Rmazze/LaserGame/README.md

# Lasertag with Arduino

This is an old project where I developed a lasertag kit with Arduino.

- In Arduino folder you can find the code for Arduino
- In pcb folder you can find the pcb board design
- In structure folder you can find the file for 3D printing the case
