Rmazze/LaserGame/lasertag_tesina.pdf

# ITT G. CHILESOTTI

# LASERTAG

# Anno scolastico 2017-2018

# Mazzaro Roberto 5^B

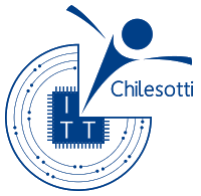
[picture p1: figure]

## Indice:

1. Introduzione
2. Fasi del progetto
3. Schema a blocchi

3.1 Schema blocchi kit

3.2 Schema a blocchi comunicazione tra due kit

4. Schema elettrico
5. PCB
6. Hardware per ricezione e trasmissione

6.1 Sensore IR

6.2 Circuito astabile con 555 per generare la frequenza di

38kHz

6.3 Dimensionamento circuito astabile

6.4 Schema elettrico circuito astabile con 555

7. Software

7.1 Acquisizione codice kit

7.2 Funzione di sparo

7.3 Funzione di ricezione

7.4 Funzione aggiornamento vita

7.5 Funzione ricarica

8. Misure con oscilloscopio
9. Struttura esterna
10. Approfondimento timer in ATMega 328
11. Listato programma

## 1. Introduzione

Cerchiamo innanzitutto di capire cos’è il lasertag.

Il lasertag è un gioco di squadra basato sulla simulazione militare.
L’attività simula, tramite apposite apparecchiature, combattimenti tra squadre avversarie. Gli obbiettivi sono vari, ma fondamentalmente lo scopo del gioco è colpire l’avversario fino alla sua eliminazione.
Ogni giocatore è munito di un kit a raggi infrarossi, totalmente innocui, collegato a dei sensori, posti generalmente sul capo o sul corpo, che devono essere colpiti.
È una tecnologia di derivazione militare, infatti è nata per l’addestramento delle forze militari.

## 2. Fasi del progetto

Il principale problema da risolvere per far funzionare questo progetto è capire come far comunicare due Arduino, ovvero il controllore utilizzato per sviluppare questo progetto, tramite un fascio infrarosso.
Risolto questo problema si può pensare al resto
Le fasi del progetto sono le seguenti
- Capire come far comunicare due Arduino tramite la funzione PulseIn()
- Capire come inserire la comunicazione con l’infrarosso
- Montare un prototipo su breadboard
- Scrivere le singole funzioni utilizzate dal software in linguaggio C
- Disegnare, sviluppare e montare il PCB
- Mettere a punto il programma generale
- Disegnare e realizzare la struttura con la stampante 3D

## 3. Schema a blocchi

### 3.1 Schema a blocchi di un kit

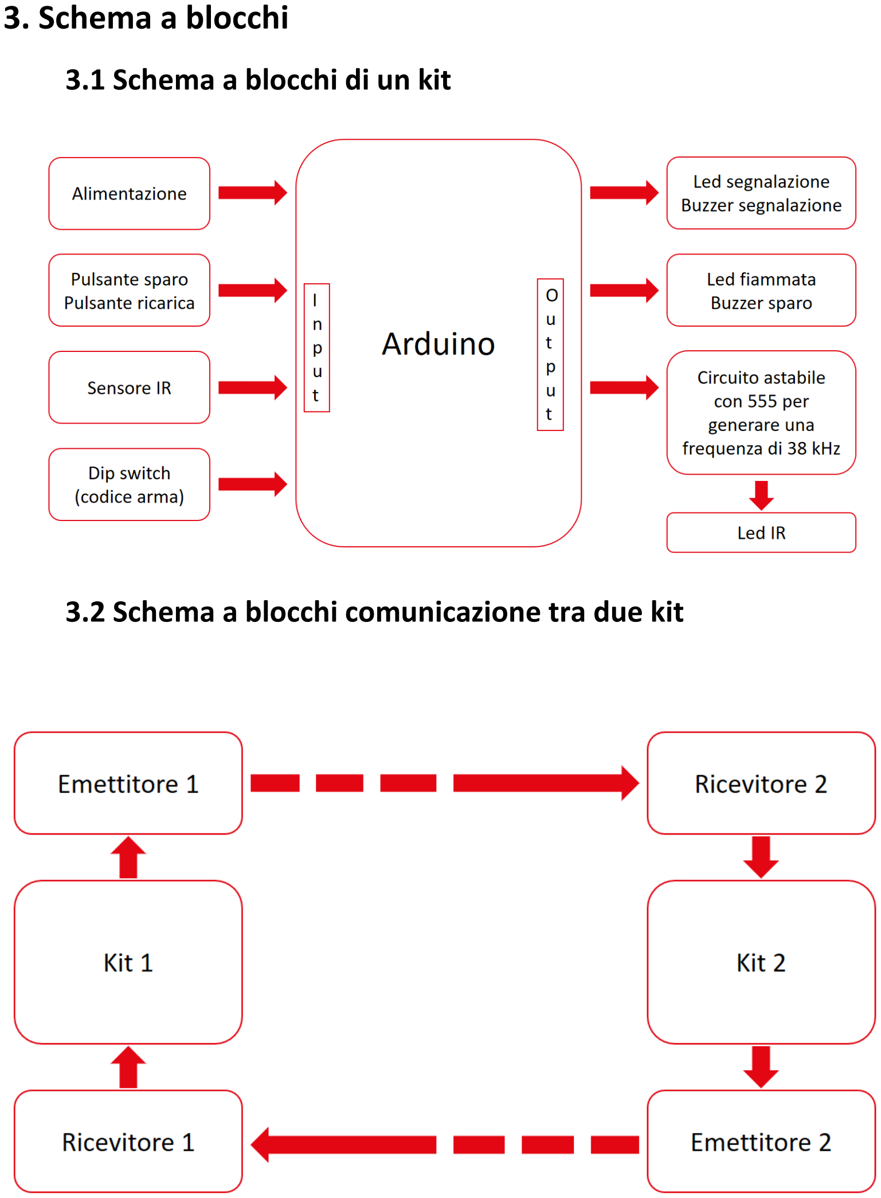
[picture p2: page 4]

### 3.2 Schema a blocchi comunicazione tra due kit

## 4. Schema elettrico

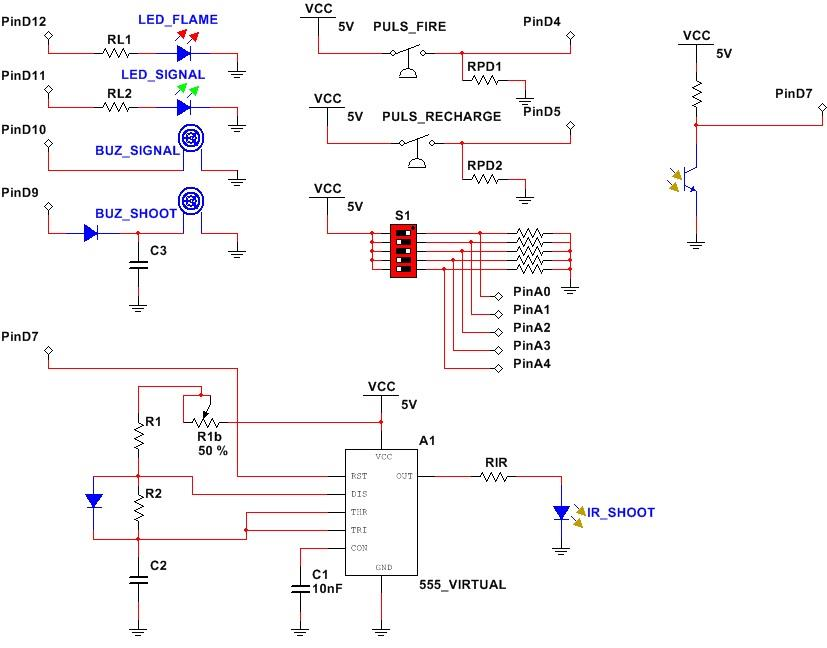
[picture p3: figure]

## 5.PCB

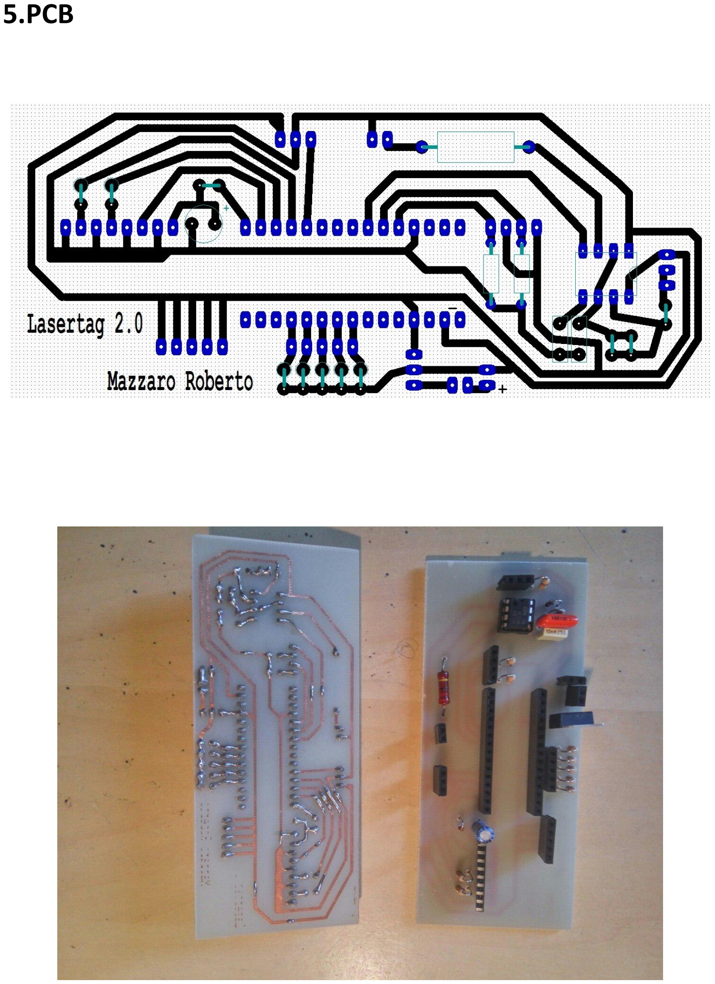
[picture p4: page 6]

## 6. Hardware

Di seguito vengono analizzate le parti principali dell’hardware.

### 6.1 Sensore IR

Il sensore infrarosso impiegato in ricezione è il TL1838.
È stato scelto perché è quello che si trova più facilmente in commercio.
Le caratteristiche peculiari di questo sensore sono:
- Frequenza di lavoro di 38kHz
- La durata minima di un impulso affinchè possa essere letto è di 600µS
- Quando riceve segnale in uscita fornisce 0V
- Quando non riceve il segnale adeguato in uscita fornisce 5V

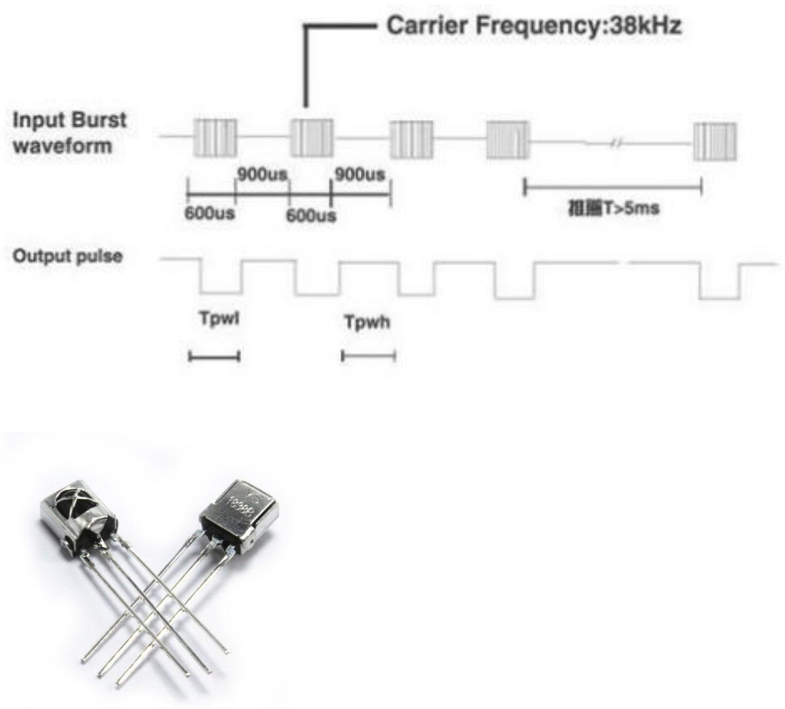
[picture p5: figure]

### 6.2 Hardware trasmissione

Dato che il sensore per funzionare correttamente necessita che gli venga fornito un segnale con una portante a 38kHz e dato che tutti i timer che mette a disposizione Arduino erano già impiegati per svolgere altre funzioni la frequenza di 38kHz viene generata tramite un 555 in configurazione astabile. Andando a pilotare il piedino di reset del 555 tramite Arduino si decide quando generare la frequenza di 38kHz che verrà spedita al kit avversario tramite un led IR collegato con un’opportuna resistenza al piedino d’uscita del 555.

### 6.3 Dimensionamento circuito astabile

f= 38kHz
T =

1
f

= 26.3µS
T = 0.7 ∗ [(R1 + R2

) ∗ C]
Scelgo C= 10nF
R1 + R2 =

T
0.7∗C

= 37571Ω
Scelgo R2= 15kΩ
R1= 12kΩ
R1B= trimmer da 10kΩ (per la regolazione dei 38kHz)

### 6.4 Schema elettrico circuito astabile con 555

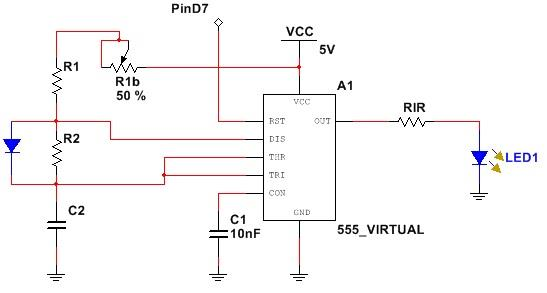
[picture p6: figure]

## 7. Software

Di seguito viene analizzato il software nelle sue componenti principali cercando di spiegare l’idea su cui esso si basa.

### 7.1: Acquisizione codice kit

Questa parte del programma viene eseguita una volta sola all’accensione perché si trova nel ´void setup()´.
Si va a fare la lettura analogica di 5 piedini che vanno da A0 ad A4,
questi piedini sono collegati ad un dip switch tramite il quale si può scegliere il codice del kit.
Vengono utilizzati dei piedini analogici per fare una lettura digitale perché erano inutilizzati e in Arduino ci sono a disposizione pochi piedini digitali. Dato che al momento sono stati acquisiti dei valori analogici questi devono essere convertiti in digitale, fatto ciò si ricava il codice della squadra e il codice dell’arma del kit, i primi due bit indicano il valore della squadra, mentre i restanti tre indicano il valore dell’arma.
In base al codice dell’arma si impostano le sue caratteristiche quali la vita, il rateo di fuoco, il numero di caricatori, i colpi per caricatore.

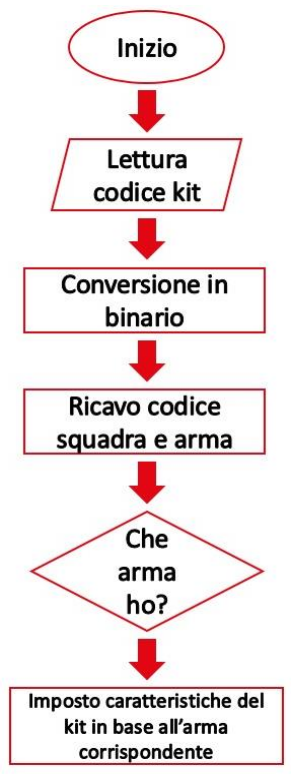
[picture p7: figure]

### 7.2 Funzione di sparo

La funzione di sparo è la funzione che si occupa di spedire il codice del kit al kit avversario.
È gestita con il timer1 che genera una frequenza che dipende dal tipo di arma selezionata, ogni volta che c’è il fronte di salita si spedisce il codice.
Per spedire il codice si agisce sul piedino di reset del 555, quando lo poniamo allo stato alto il 555 genera la frequenza di 38kHz.
Ad inizio trasmissione viene spedito il bit di start e per far ciò il reset del 555 viene abilitato per 1000µS.
Successivamente si spediscono il codice della squadra e quello dell’arma; per spedire un bit a 1 si abilita il reset del 555 per 800µS, mentre per spedire un bit a 0 lo si abilita per 600µS.
Dato che sia che si stia spedendo il bit di start uno 0 o un 1 si sta sempre spedendo un segnale infrarosso a 38kHz, solo che con diversa durata, per separare un bit dall’altro non si spedisce niente per 600µS.
Ogni volta che si spara, oltre a spedire il codice con il metodo precedentemente spiegato, si attivano anche il buzzer di sparo ed il led di fiammata e si scala un colpo dai colpi nel caricatore.
Gestire questa funzione con un interrupt è importante perché il programma deve essere sempre pronto a riceve un colpo avversario e per far ciò il programma non deve ‘bloccarsi’, quindi non ci possono essere delay inutili o eccessivamente lunghi.

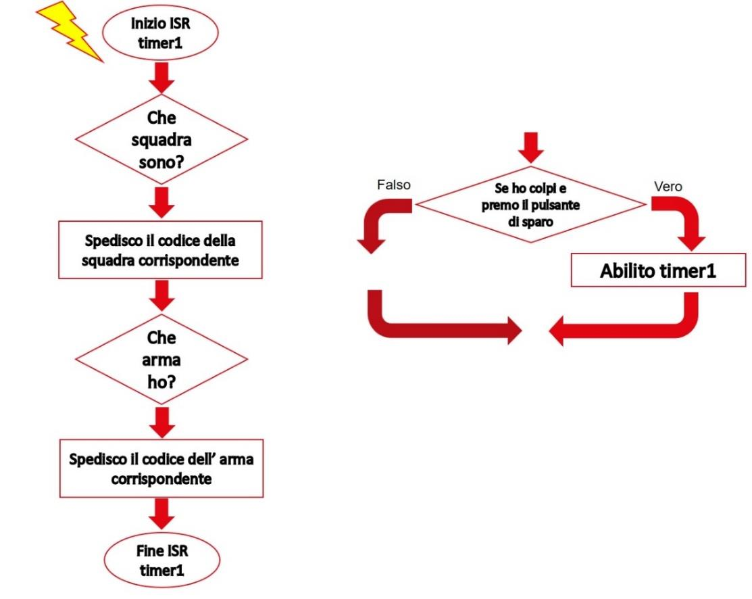
[picture p8: figure]

### 7.3 Funzione di ricezione

La funzione di ricezione si basa sulla funzione pulseIn(), che è una funzione già esistente nelle librerie di Arduino.
PulseIn() è una funzione che si occupa di restituire il valore in µS della durata dello stato alto o di quello basso in base al fatto che si decida di prendere come riferimento il fronte di salita o quello di discesa.
Viene utilizzata la funzione pulseIn() con l´opzione, già presente in essa, di inserire un timeout ovvero un tempo massimo entro il quale se non arriva il fronte desiderato la funzione pulseIn() procede oltre e ci restituisce come risultato 0µS.
I timeout sono necessari perché il programma non può restare ad aspettare un colpo che non si sa quando arriva e dobbiamo poter svolgere anche le altre azioni.
I timeout, se non vengono impostati, di base sono ad 1S.

Per ricevere il codice bisogna innanzitutto individuare il bit di start, per far ciò c’è un ciclo while che lavora fino a quando pulseIn() non rileva uno stato basso della durata di almeno 950µS, questo perché il bit di start dura 1000µS e ci vuole un po’ di margine;
all’interno del ciclo while si trova il resto del programma.
Rilevato il bit di start si esce dal ciclo while e tramite altri 5 pulseIn() si vanno ad acquisire le durate degli altri impulsi che successivamente vengono convertiti in 0 e 1, fatto ciò si ricavano il codice della squadra e dell’arma di chi ci ha colpito e si richiama la funzione di aggiornamento vita.

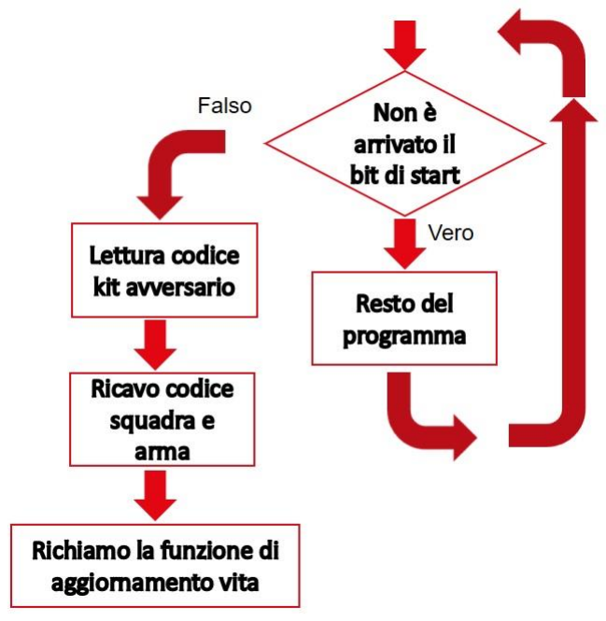
[picture p9: figure]

### 7.4 Funzione aggiornamento vita

Questa funzione viene eseguita dopo che si è stati colpiti e che i codici della squadra e dell’arma di colui che ci ha colpito sono stati ricavati.
Innanzitutto si fa un controllo per verificare che la squadra del kit che ha ricevuto il colpo sia diversa da quella del kit che l’ha spedito, se sono diverse allora, in base al codice dell’arma che ci ha colpito, si decrementa la variabile vita in base al danno che fa quell’arma, inoltre si accende il led ed il buzzer di segnalazione per segnalare che siamo stati colpiti.
Nel caso in cui le due squadre siano uguali il colpo non viene registrato e non si perde vita; è stato deciso di disabilitare il fuoco amico perché dato che il colpo è spedito tramite un fascio infrarosso che può essere riflesso c’era il rischio di colpirsi da soli.

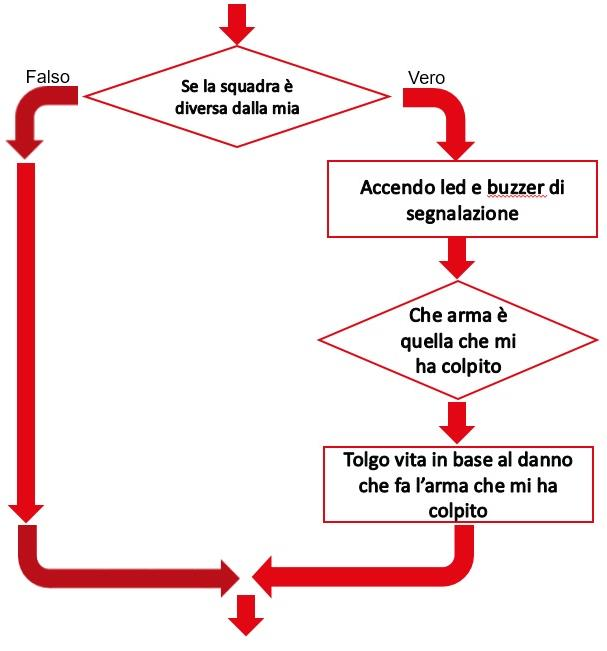
[picture p10: figure]

### 7.5 Funzione di ricarica

La funzione di ricarica viene eseguita quando si preme il pulsante di ricarica se si hanno ancora caricatori a disposizione.
Appena premuto il pulsante di ricarica si azzera la variabile colpi, così non è possibile sparare, inoltre si accendono e si spengono il led ed il buzzer di segnalazione.
Questa funzione è gestita con il timer2 impostato ad una frequenza fissa di 2kHz, per ottenere i vari tempi di ricarica richiesti dalle varie armi si aspetta che vengano eseguiti un certo numero di cicli dal timer, quindi c’è una variabile che tiene conto di quanti giri fa il timer e raggiunto il numero di cicli necessari si rispristinano i colpi nel caricatore e si decrementa la variabile caricatori.
È stato necessario adottare questa soluzione per il conteggio del tempo di ricarica perché il timer2 è un timer a soli 8 bit e con esso non è possibile ottenere i periodi lunghi necessari in questa funzione.

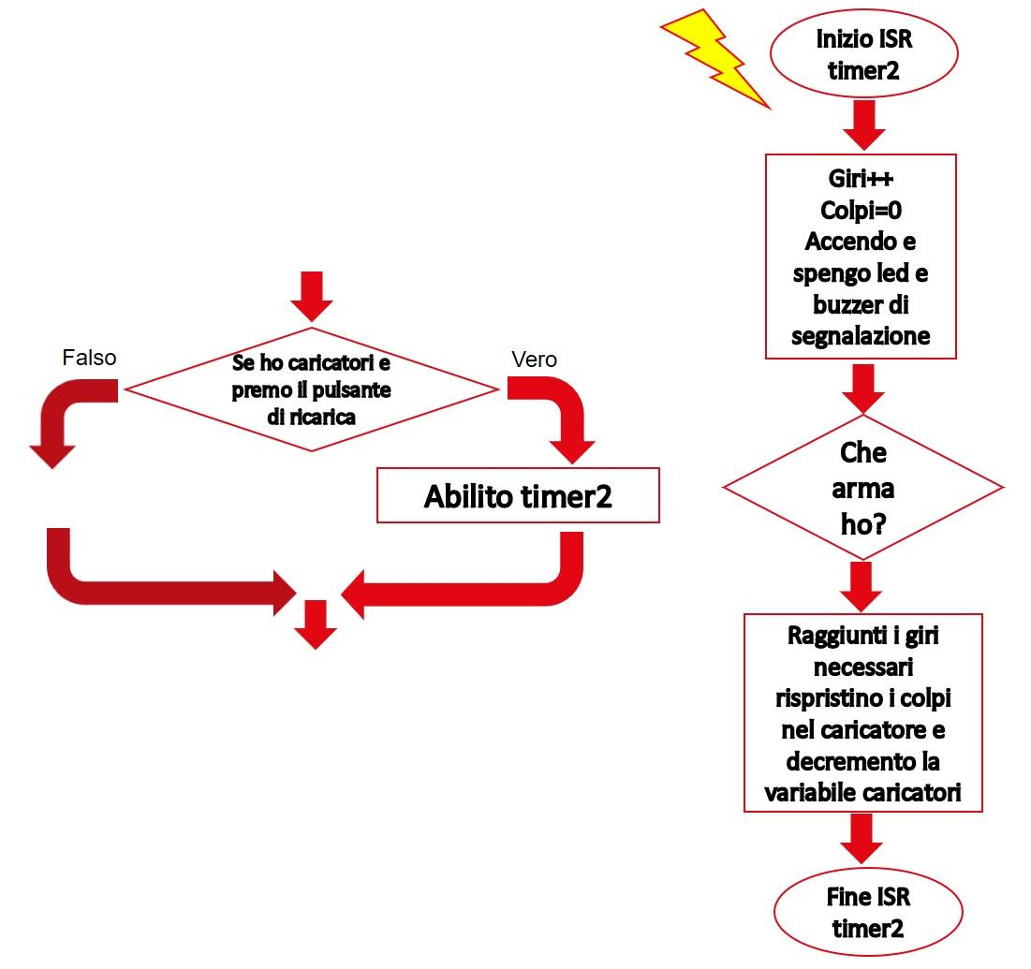
[picture p11: figure]

## 8. Misure con oscilloscopio

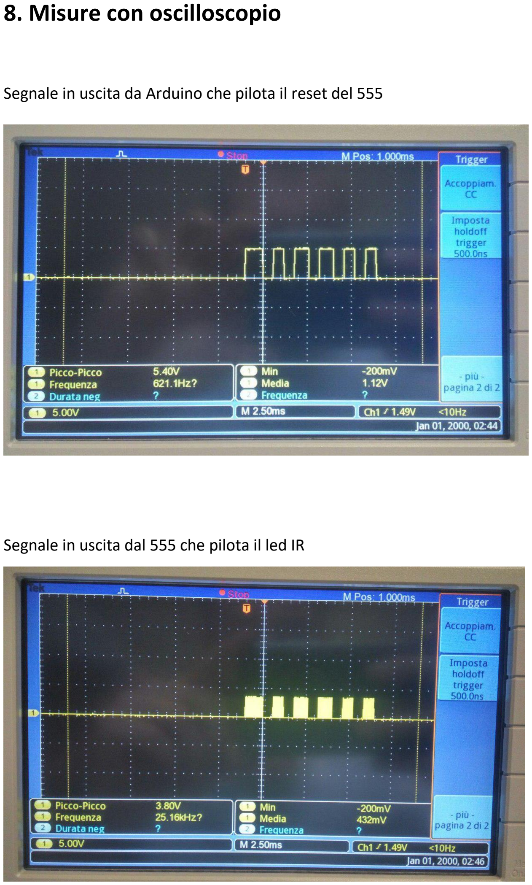
[picture p12: page 14]

Segnale in uscita da Arduino che pilota il reset del 555

Segnale in uscita dal 555 che pilota il led IR

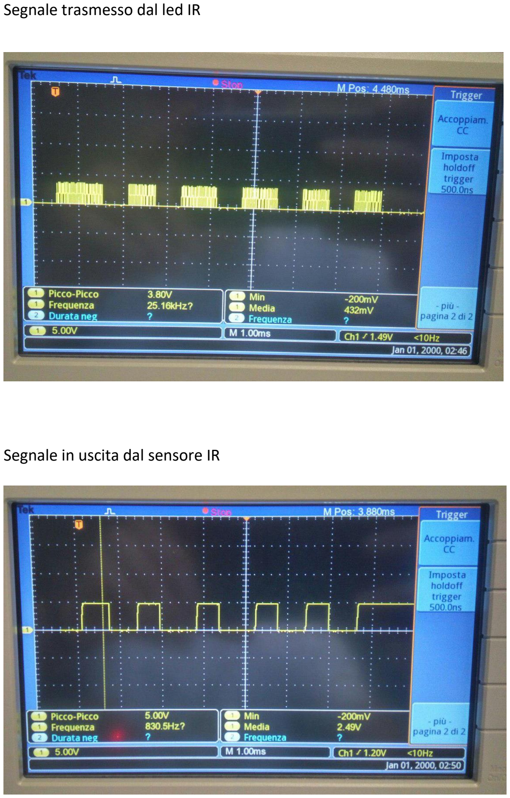
[picture p13: page 15]

Segnale trasmesso dal led IR

Segnale in uscita dal sensore IR

## 9. Struttura esterna

Il progetto della struttura esterna è stato realizzato con un programma di disegno 3D adatto alla creazione di file STL, ovvero il formato richiesto per la stampa in 3D, infatti la struttura esterna è stata successivamente realizzata con la stampante 3D.

Progetto in cad dell’ottica

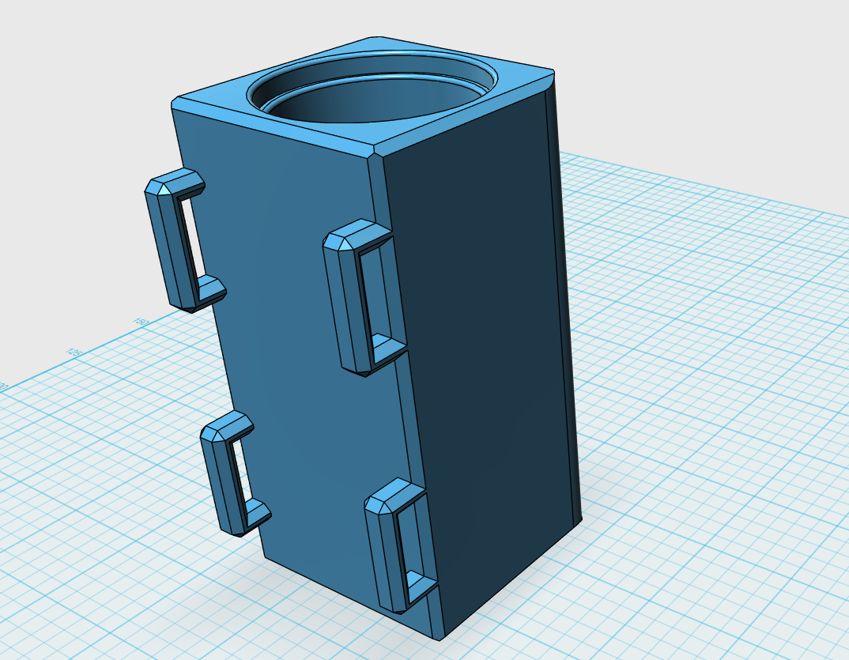
[picture p14: figure]
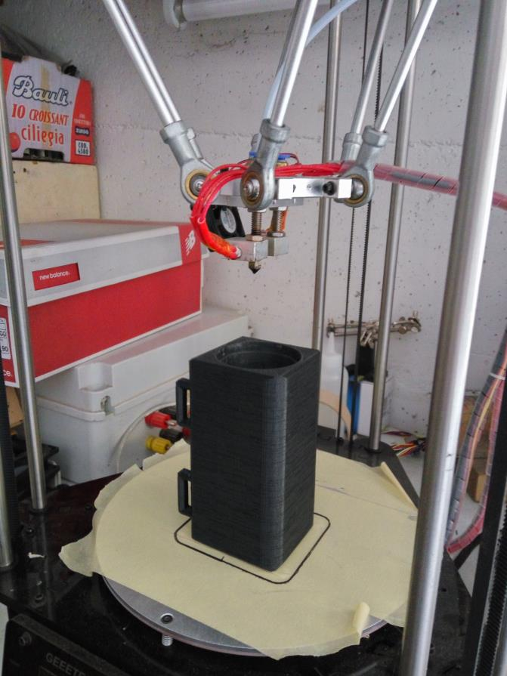
[picture p15: figure]

Ottica realizzata

## 10. Approfondimento timer in ATMega 328

L’ATMega 328, il microcontrollore presente in Arduino nano, mette a disposizione tre timer, di cui due a 8 bit (timer0 e timer2) e uno a 16 bit (timer1).

I registri più importanti di un timer sono:

TCNTn: è il registro di conteggio
OCRn: è il registro di comparazione, quando TCNTn raggiunge il valore impostato in OCRn succede qualcosa in base alla modalità con cui stiamo utilizzando il timer
OCn: è l’uscita del timer
TCCRnA TCCRnB: servono per impostare la modalità di funzionamento del timer

I timer possono essere utilizzati in quattro diverse modalità:

Normal mode: la direzione del conteggio è sempre in avanti, si incrementa TCNTn ogni volta che arriva un impulso e quando si arriva al numero massimo si riparte a contare da 0.

Fast PWM mode: si basa su un meccanismo a singola rampa, il contatore conta dal minimo al massimo e poi riparte dal minimo.
Quando TCNTn e OCRn sono uguali OCn viene resettato e successivamente torna allo stato alto quando TCNTn raggiunge il valore massimo.
Grazie al suo funzionamento a singola rampa questa modalità consente di avere una frequenza doppia in confronto alla modalità Phase correct PWM e ciò la rende adatta per regolazioni di potenza.

Phase correct PWM mode: si basa su un meccanismo a doppia rampa, il contatore continua a contare dal minimo al massimo e dal massimo al minimo, quando TCNTn e OCRn diventano uguali l’uscita OCn cambia stato.
Viene preferito per il controllo dei motori.

Clear time on compare match (CTC) mode: è la modalità utilizzata per ottenere una frequenza.
TCNTn conta partendo dal minimo e quando raggiunge il volare di OCRn TCNTn si azzera e OCn cambia di stato.

Per questo progetto i timer sono stati utilizzati in modalità CTC quindi di seguito è illustrato come si impostano i registri per farli funzionare in tale modalità.

La frequenza del timer si calcola tramite la seguente formula:

fOCn =

fclk
2N(1 + OCRn)

In Arduino fclk è 16MHz
N è il prescaler e può valere (1, 8, 64, 256, 1024)

Tramite la formula inversa si può ricavare il valore di OCRn per ottenere la frequenza che desideriamo.

OCRn =

fclk
2N ∗ fOCn

− 1

Questo valore deve essere minore di 256 nel caso in cui il timer sia ad 8 bit o minore di 65536 con il timer a 16 bit, tuttavia si cerca sempre di avere il valore più alto tra quelli consentiti per avere una maggior precisone.

Per abilitare il CTC mode si impostano i bit WGM00 WGM01 WGM02 come da tabella

TCCRnA

TCCRnB

Per impostare che OCn commuti al compare match si impostano i bit COMA0 COMA1 come da tabella.

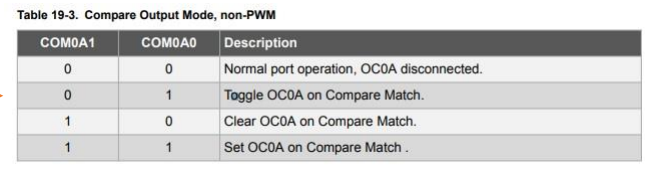
[picture p16: figure]

Per impostare il prescaler ci sono tre bit CAn2, CAn1, CSn0 che vanno impostati come da tabella

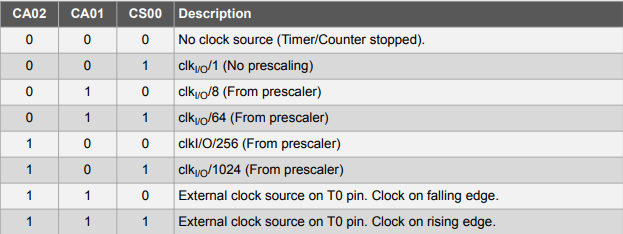
[picture p17: figure]

## 11. Listato programma

Inizializzazioni

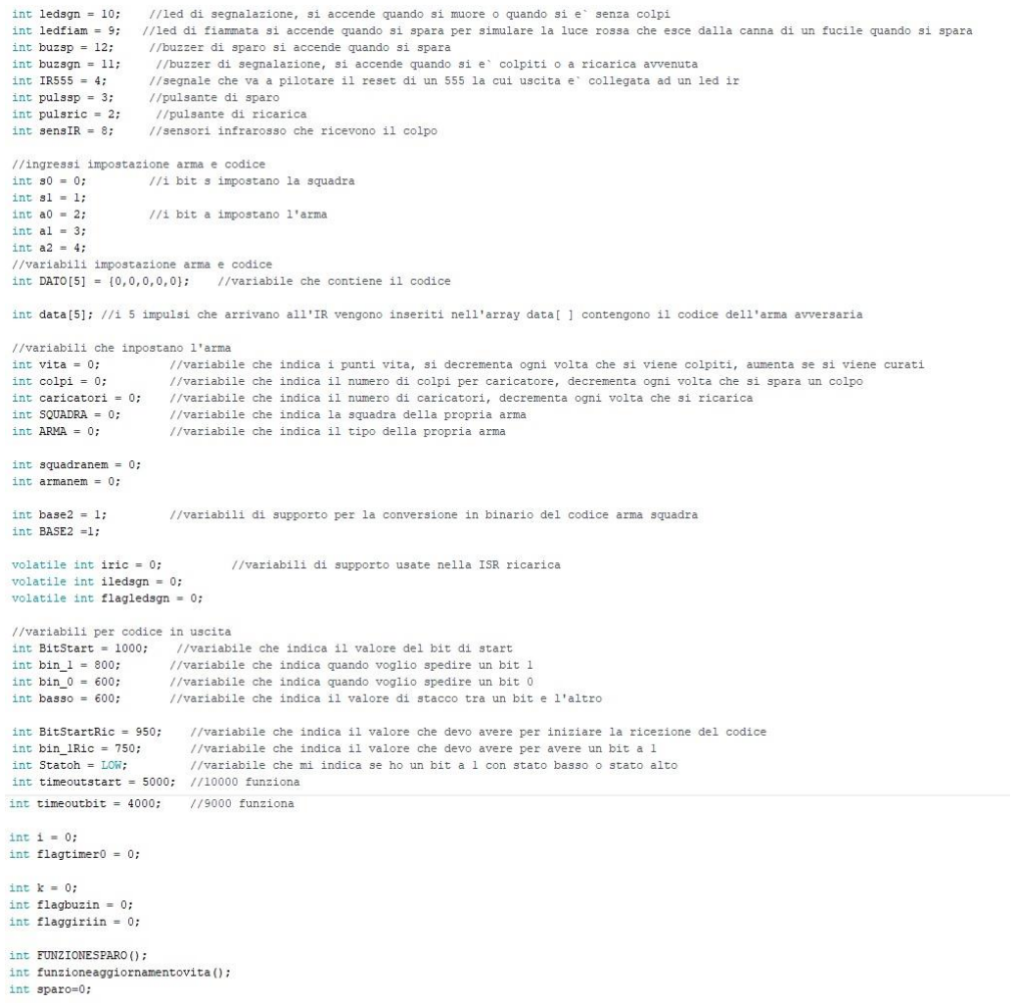
[picture p18: figure]
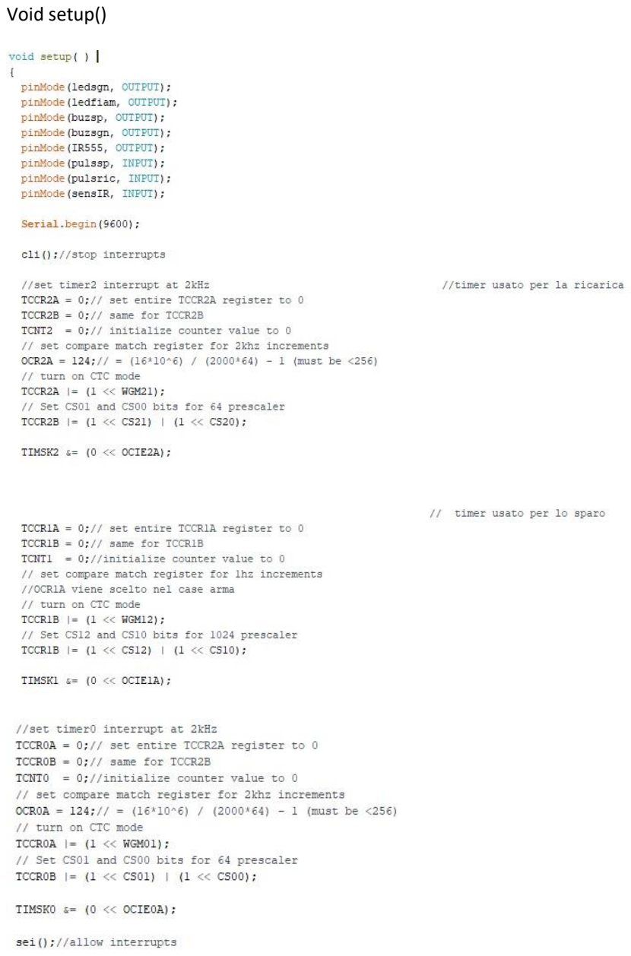
[picture p19: page 21]

Void setup()

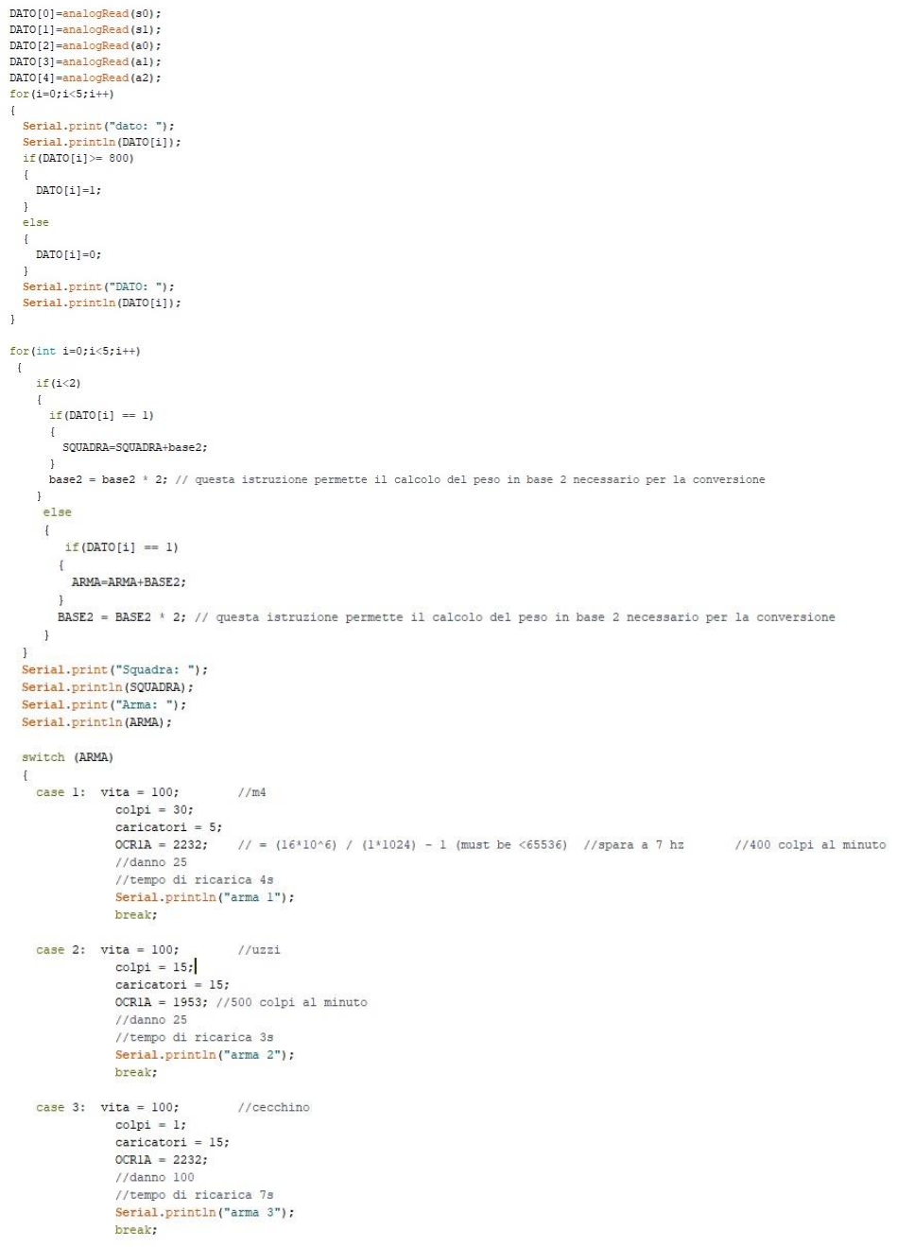
[picture p20: figure]

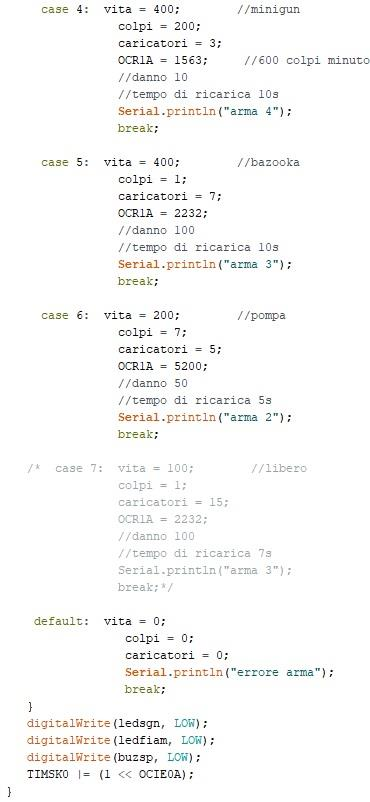
[picture p21: figure]

void loop()

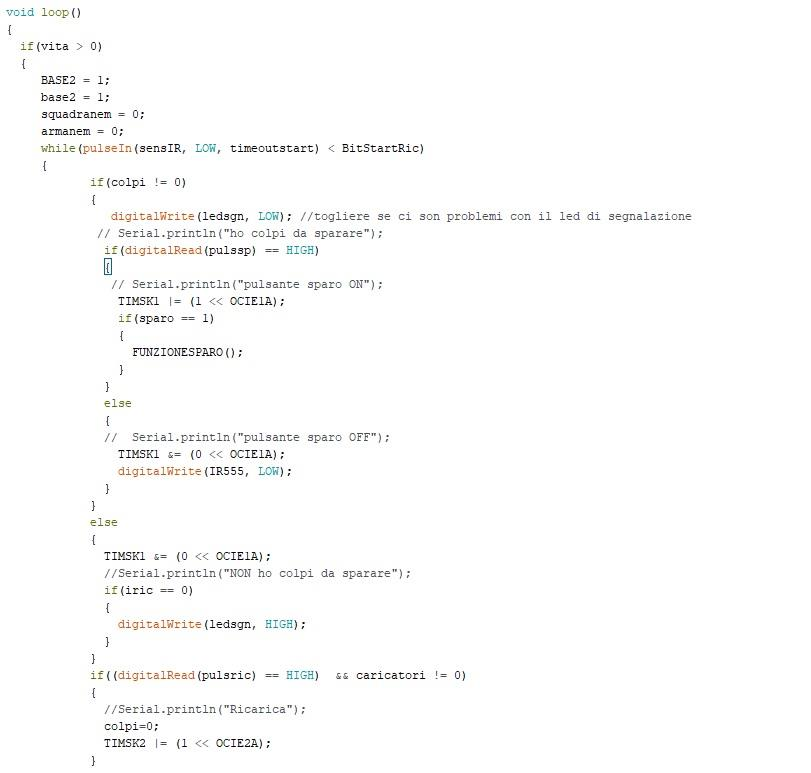
[picture p22: figure]
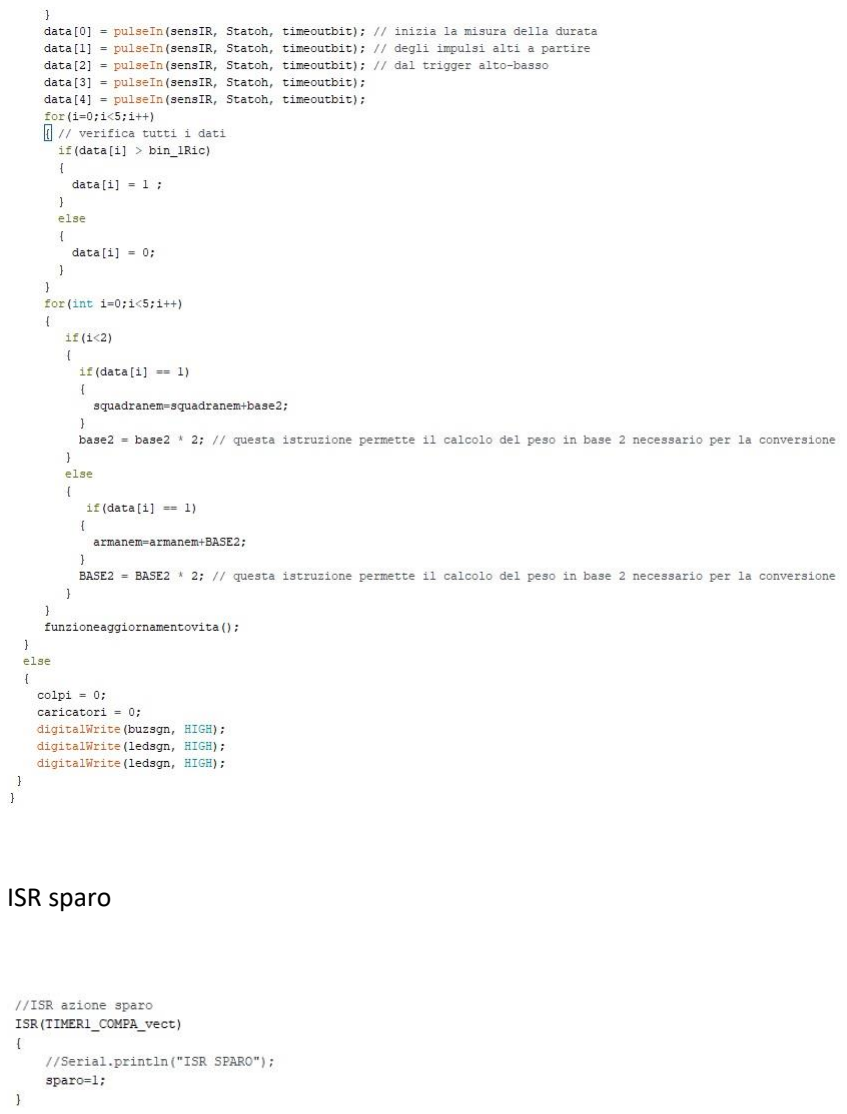
[picture p23: page 25]

ISR sparo

Funzione di sparo

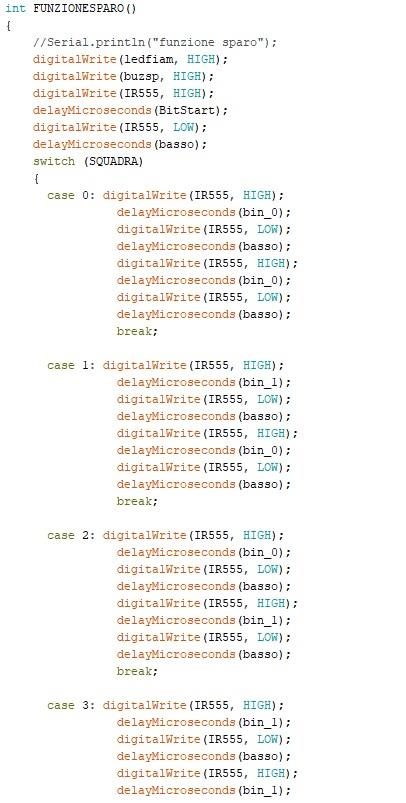
[picture p24: figure]

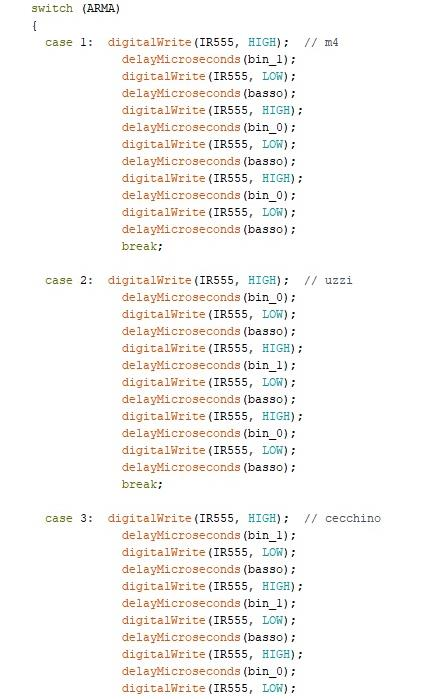
[picture p25: figure]
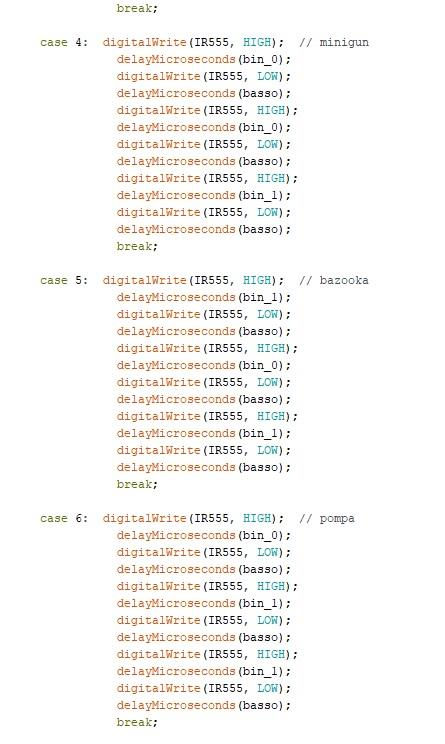
[picture p26: figure]

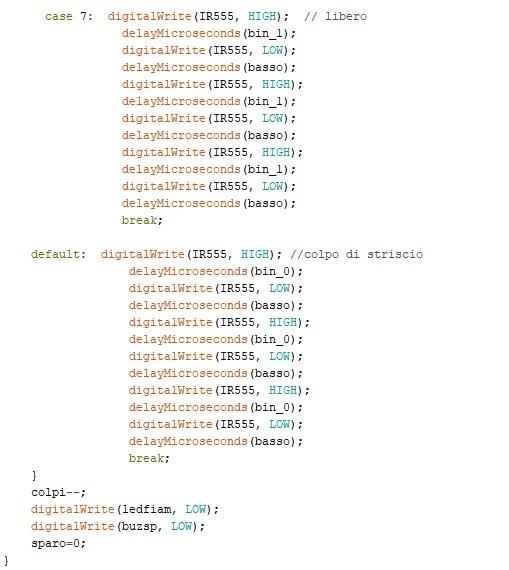
[picture p27: figure]

Funzione aggiornamento vita

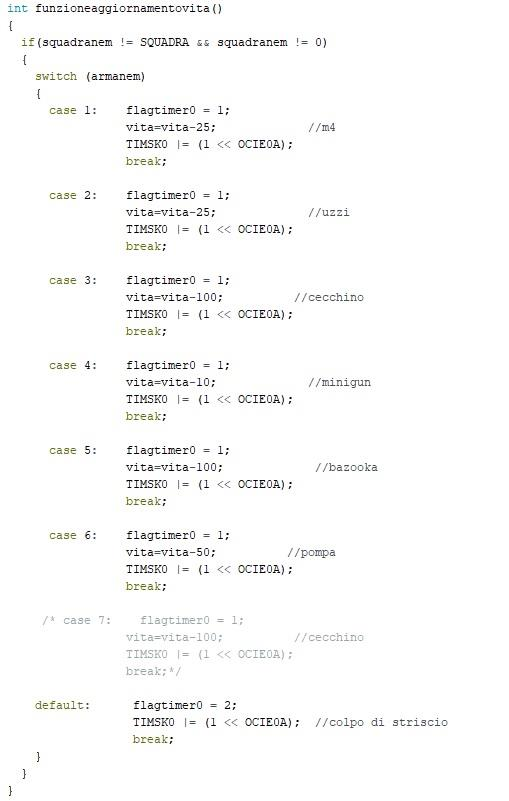
[picture p28: figure]

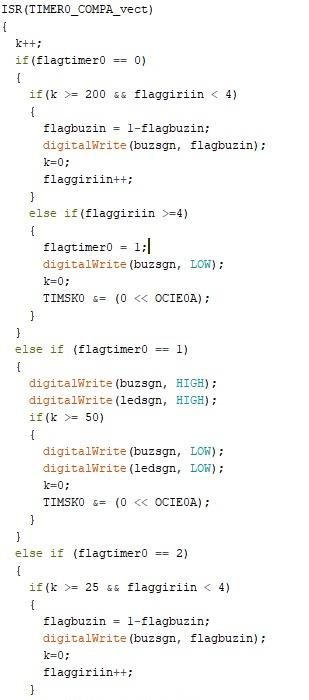
[picture p29: figure]
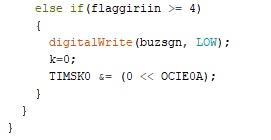
[picture p30: figure]
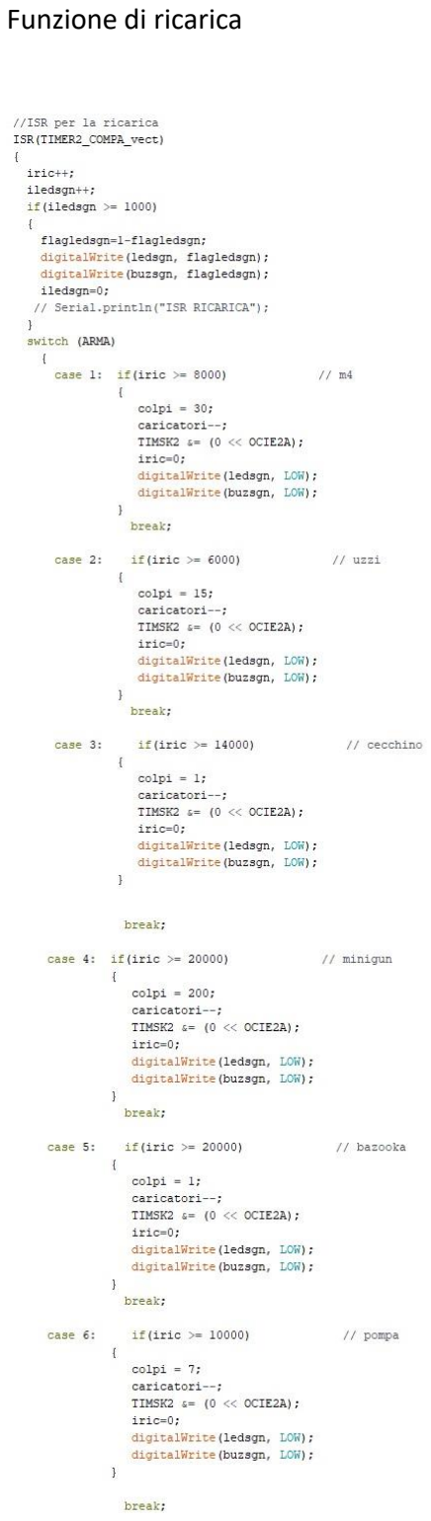
[picture p31: page 30]

Funzione di ricarica

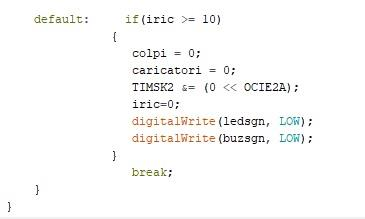
[picture p32: figure]
