Rmazze/LaserGame/presentazione_lasertag.pdf

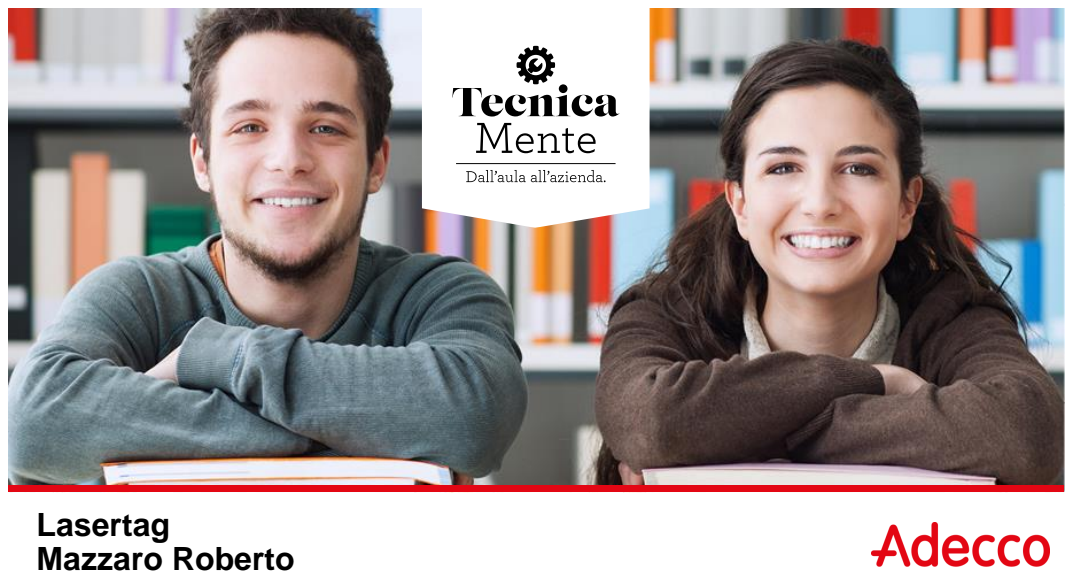
[picture p33: page 1]
Lasertag Mazzaro Roberto

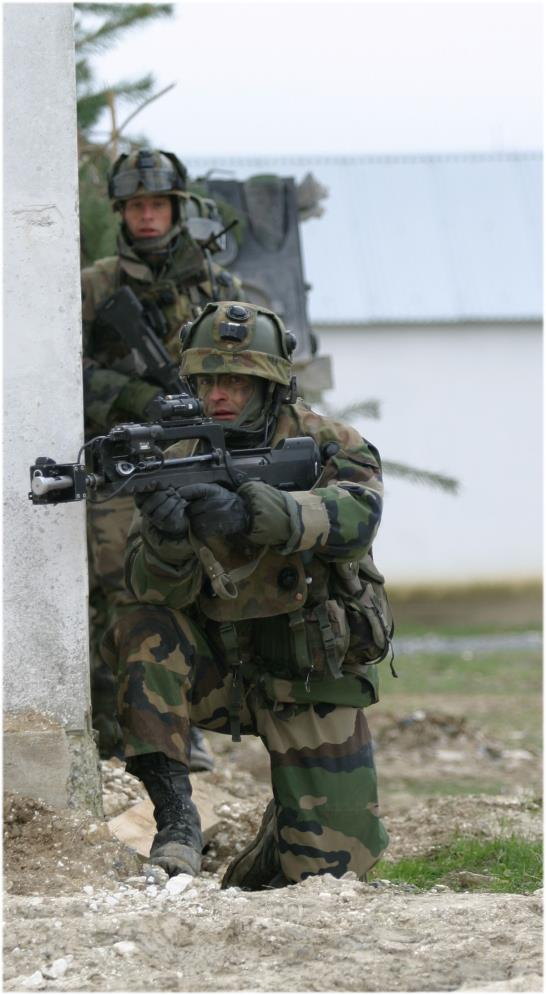
[picture p34: figure]
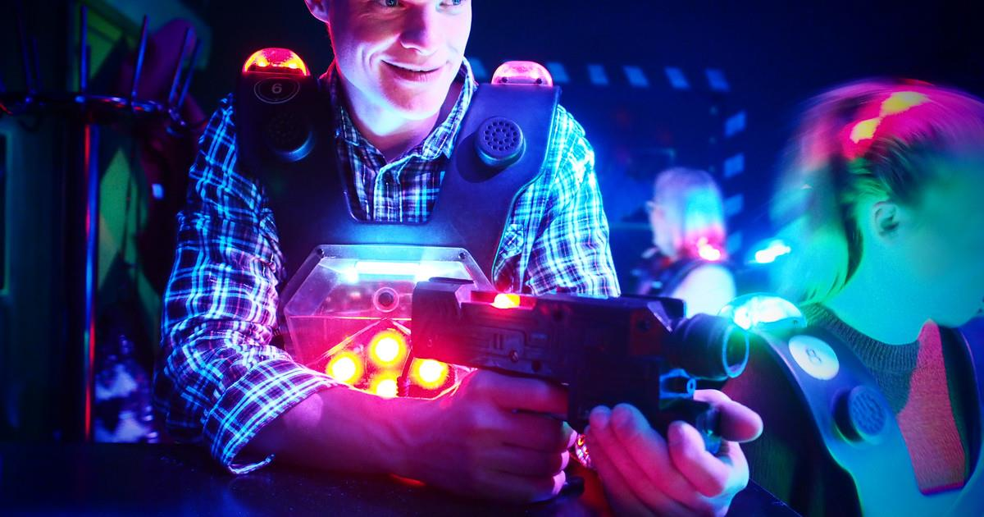
[picture p35: figure]

© Adecco | Slide | 2

# Obbiettivo

Lasertag Mazzaro Roberto ITT G.Chilesotti 5^B

Cos’è il lasertag?

- Gioco di squadra
- Basato sulla simulazione militare
- Usato nell’addestramento militare

Riprodurre il gioco del lasertag

Come funziona?

•Si è muniti di un kit che può sparare e ricevere i colpi
•Bisogna colpire l’avversario fino ad eliminarlo

# Fasi di progetto

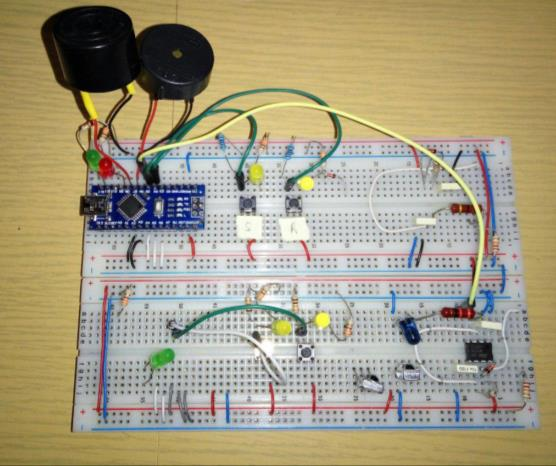
[picture p36: figure]

- Capire come far comunicare due Arduino tramite la funzione PulseIn()
- Capire come inserire la comunicazione infrarosso
- Montare un prototipo su breadboard
- Scrivere le singole funzioni utilizzate nel software

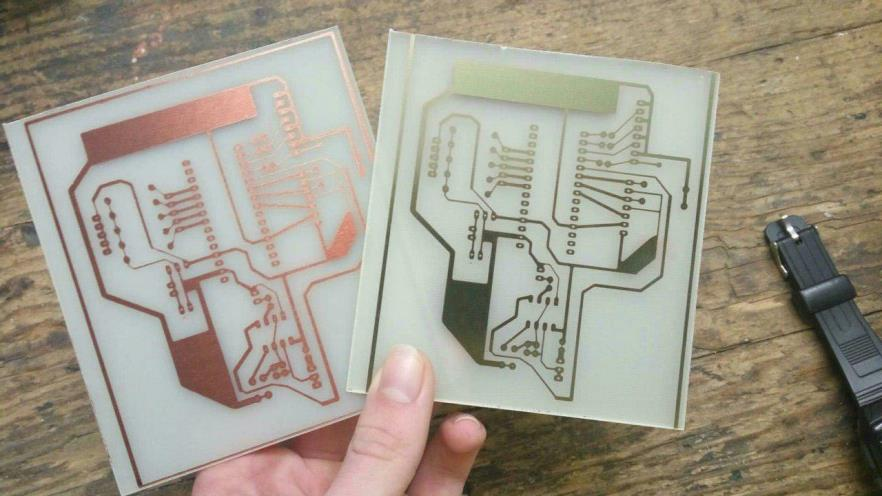
[picture p37: figure]
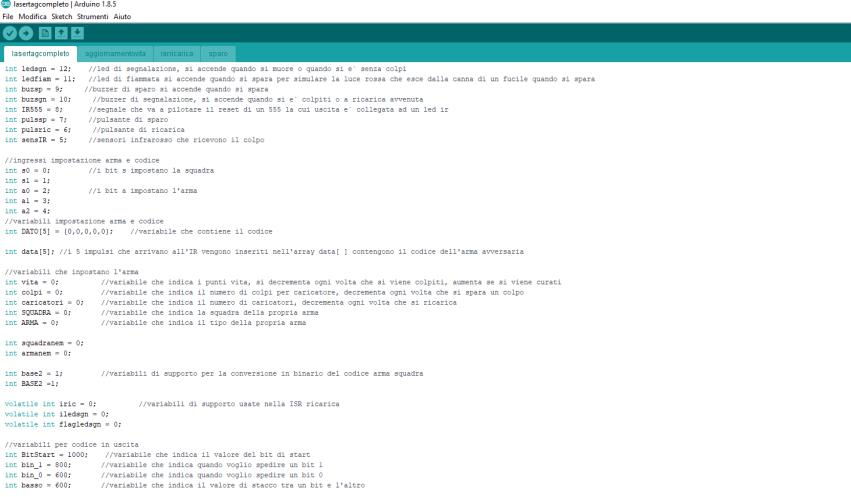
[picture p38: figure]

- Disegrare, sviluppare e montare il PCB
- Mettere a punto il programma generale
- Disegnare la struttura per stampa in 3D
- Realizzare la struttura

# Schema a blocchi di un kit

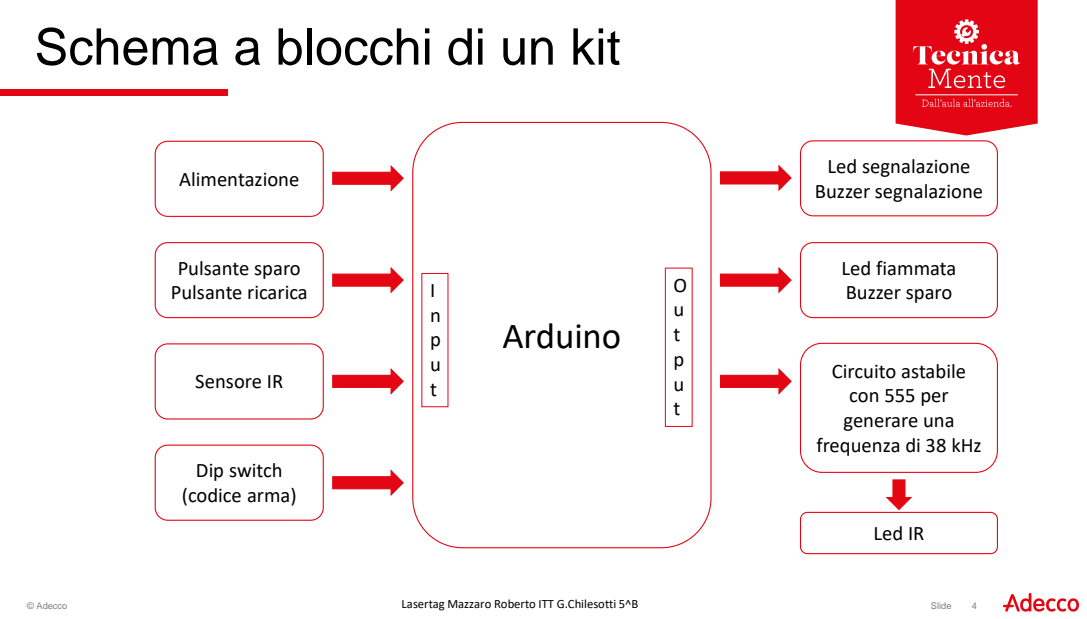
[picture p39: page 4]
Arduino; Pulsante sparo Pulsante ricarica; Alimentazione; Sensore IR; Dip switch (codice arma); Led segnalazione Buzzer segnalazione; Led fiammata Buzzer sparo; Led IR

Circuito astabile
con 555 per
generare una
frequenza di 38 kHz

# Hardware ricezione

# Sensore IR

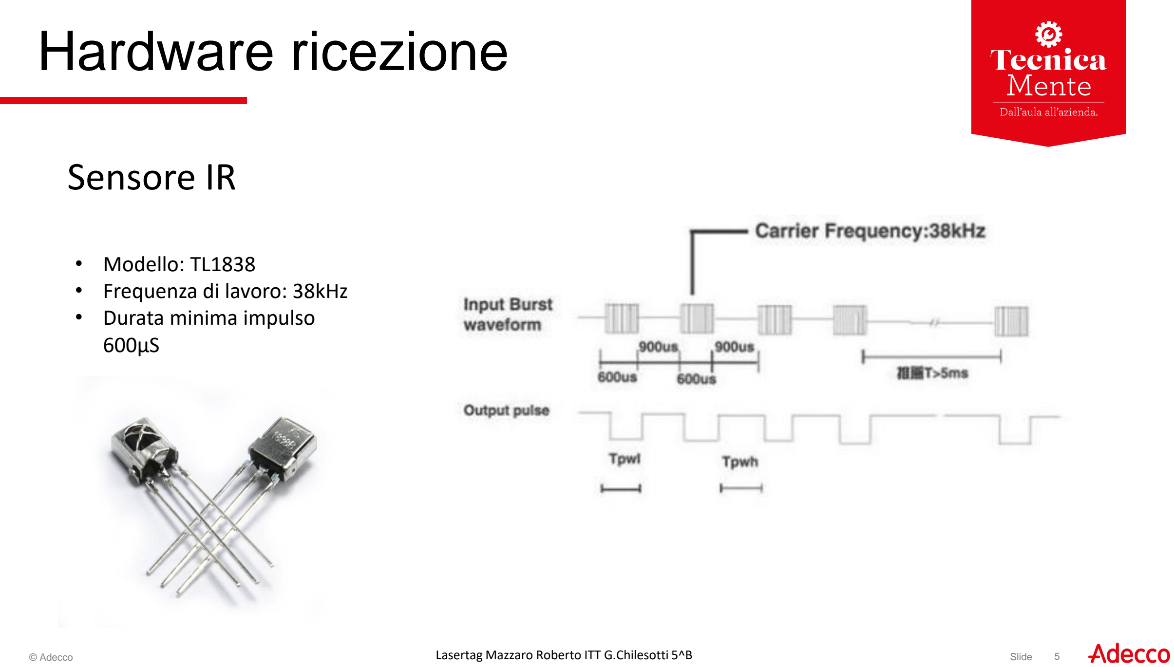
[picture p40: page 5]

- Modello: TL1838
- Frequenza di lavoro: 38kHz
- Durata minima impulso
600µS

# Hardware trasmissione

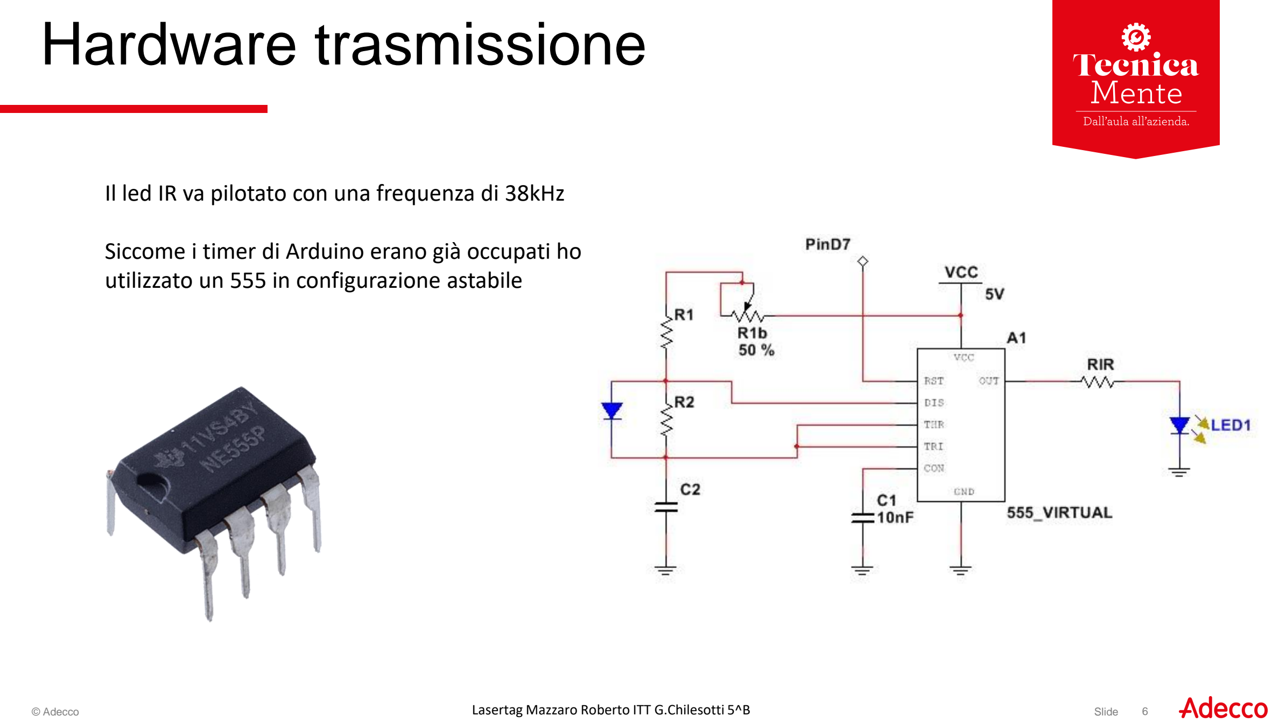
[picture p41: page 6]

Il led IR va pilotato con una frequenza di 38kHz

Siccome i timer di Arduino erano già occupati ho utilizzato un 555 in configurazione astabile

# Misure con oscilloscopio

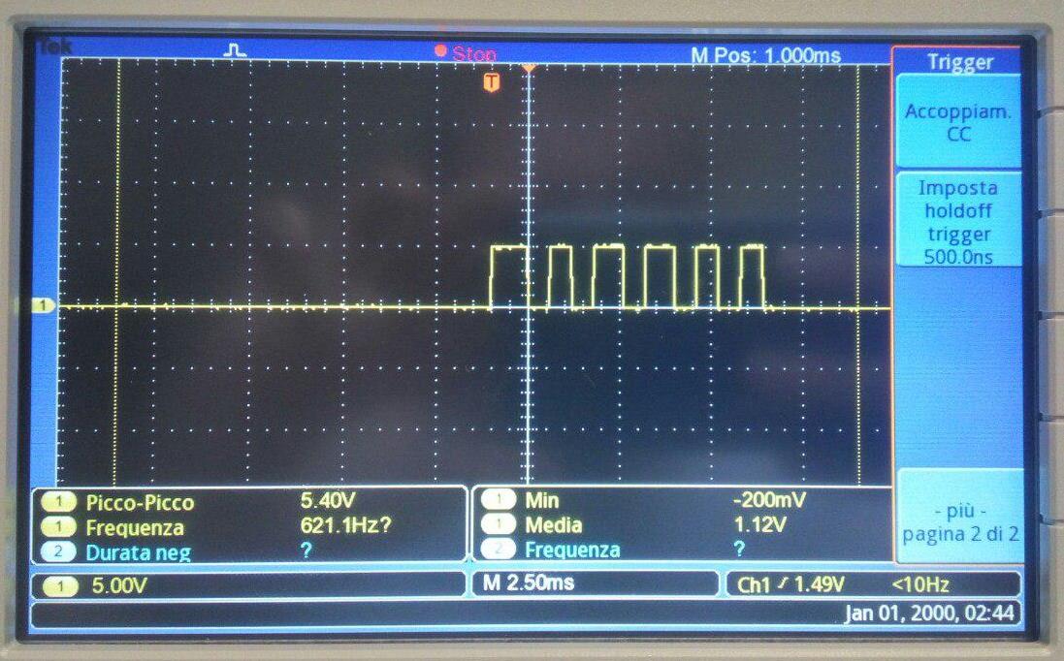
[picture p42: figure]

Segnale in uscita da
Arduino che pilota il
reset del 555

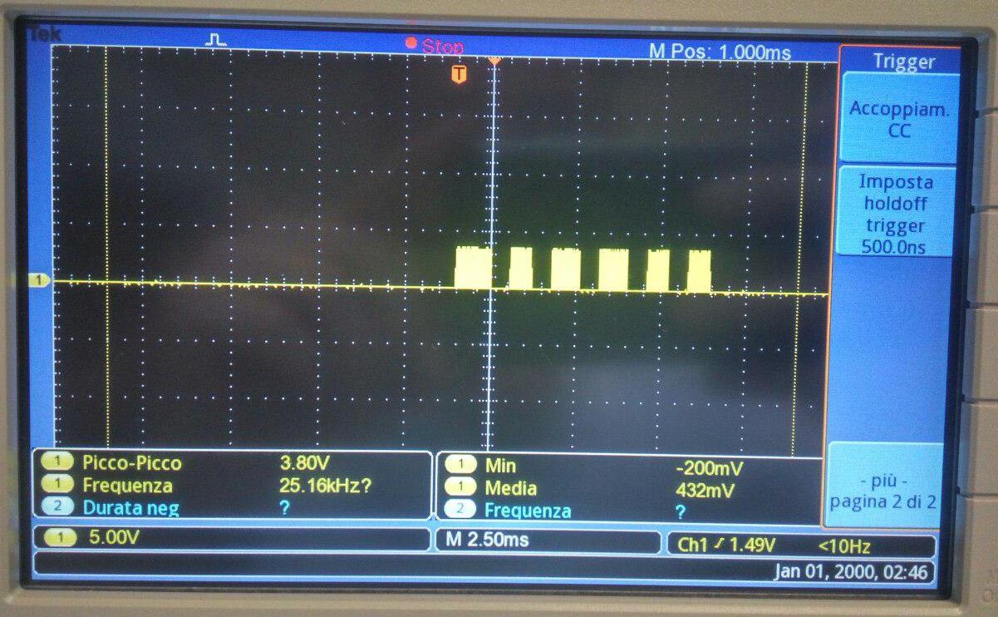
[picture p43: figure]

Uscita del 555, che
viene trasmessa
dal led IR

# Misure con oscilloscopio

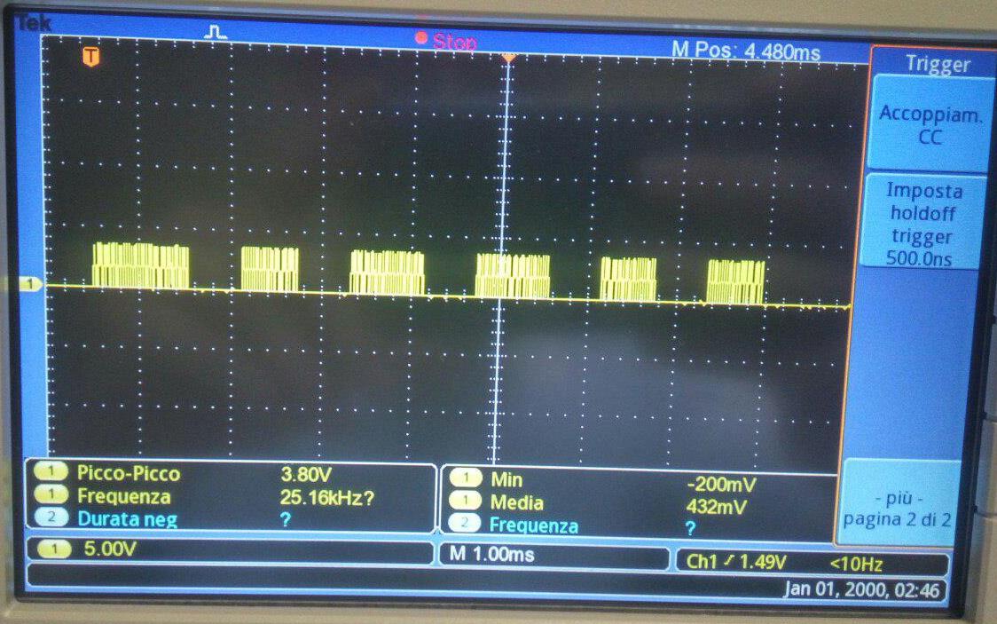
[picture p44: figure]

Segnale trasmesso dal
led IR

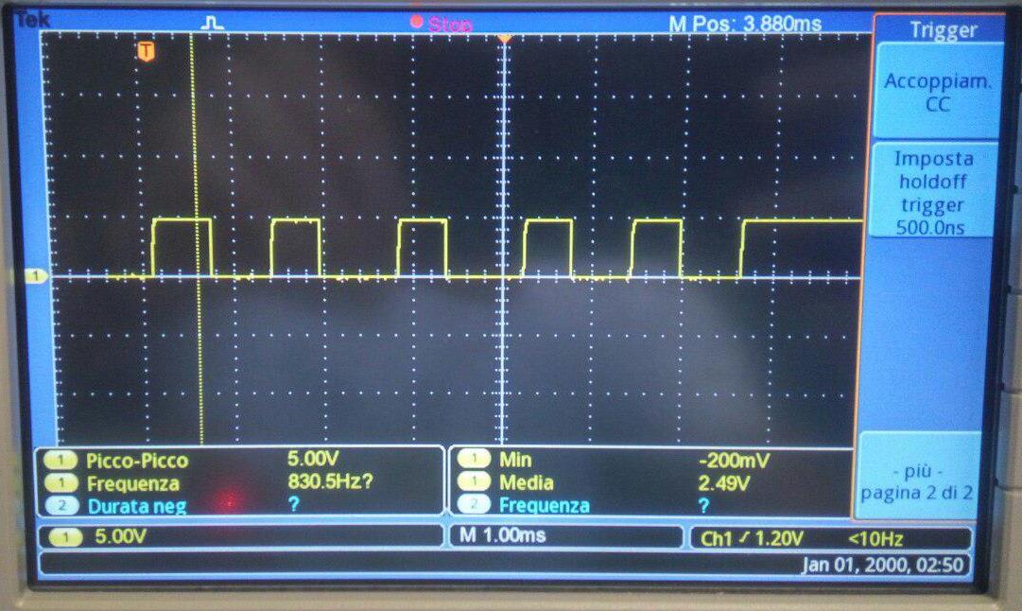
[picture p45: figure]

Segnale in uscita
dal sensore IR

# Software

# Acquisizione codice arma

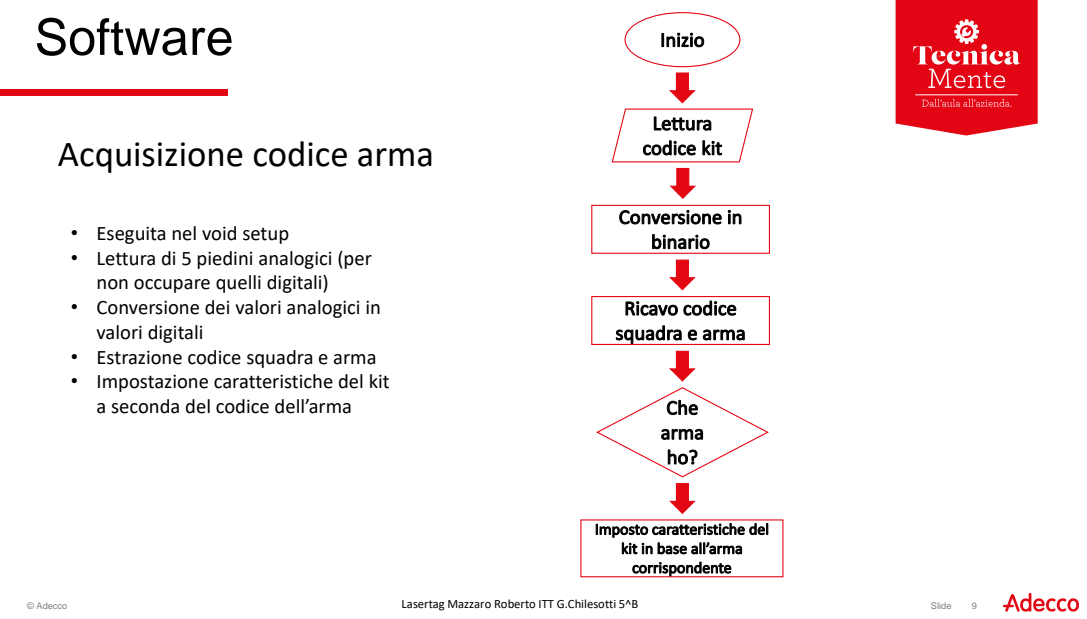
[picture p46: page 9]

• Eseguita nel void setup
• Lettura di 5 piedini analogici (per
non occupare quelli digitali)
• Conversione dei valori analogici in
valori digitali
• Estrazione codice squadra e arma
• Impostazione caratteristiche del kit
a seconda del codice dell’arma

# Software

# Funzione di sparo

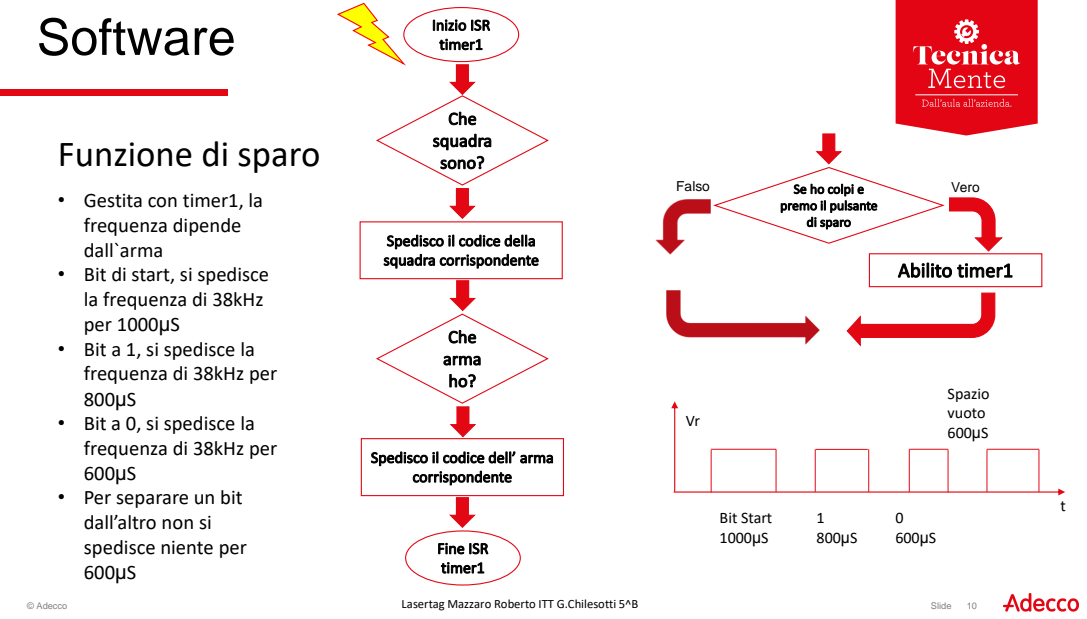
[picture p47: page 10]
Bit Start 1000µS; Spazio vuoto 600µS; Falso; Vero

• Gestita con timer1, la
frequenza dipende
dall`arma
• Bit di start, si spedisce
la frequenza di 38kHz
per 1000µS
• Bit a 1, si spedisce la
frequenza di 38kHz per
• Bit a 0, si spedisce la
• Per separare un bit
dall’altro non si
spedisce niente per

# Software

# Funzione di ricezione

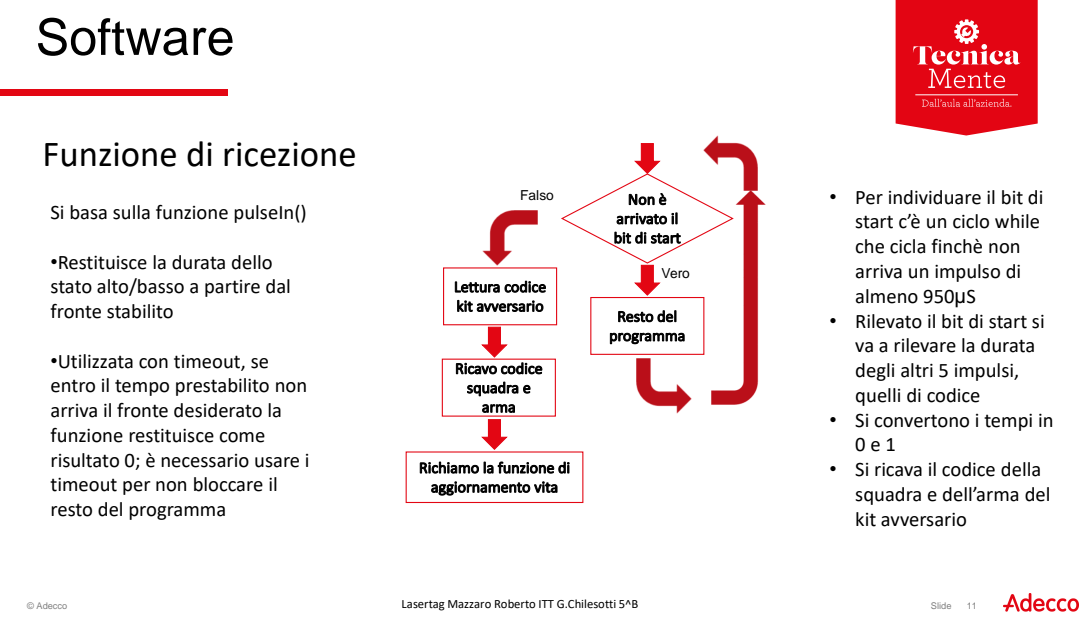
[picture p48: page 11]
Vero; Falso

• Per individuare il bit di
start c’è un ciclo while
che cicla finchè non
arriva un impulso di
almeno 950µS
• Rilevato il bit di start si
va a rilevare la durata
degli altri 5 impulsi,
quelli di codice
• Si convertono i tempi in
• Si ricava il codice della
squadra e dell’arma del
kit avversario

Si basa sulla funzione pulseIn()

•Restituisce la durata dello
stato alto/basso a partire dal
fronte stabilito

•Utilizzata con timeout, se
entro il tempo prestabilito non
arriva il fronte desiderato la
funzione restituisce come
risultato 0; è necessario usare i
timeout per non bloccare il
resto del programma

# Software

# Funzione

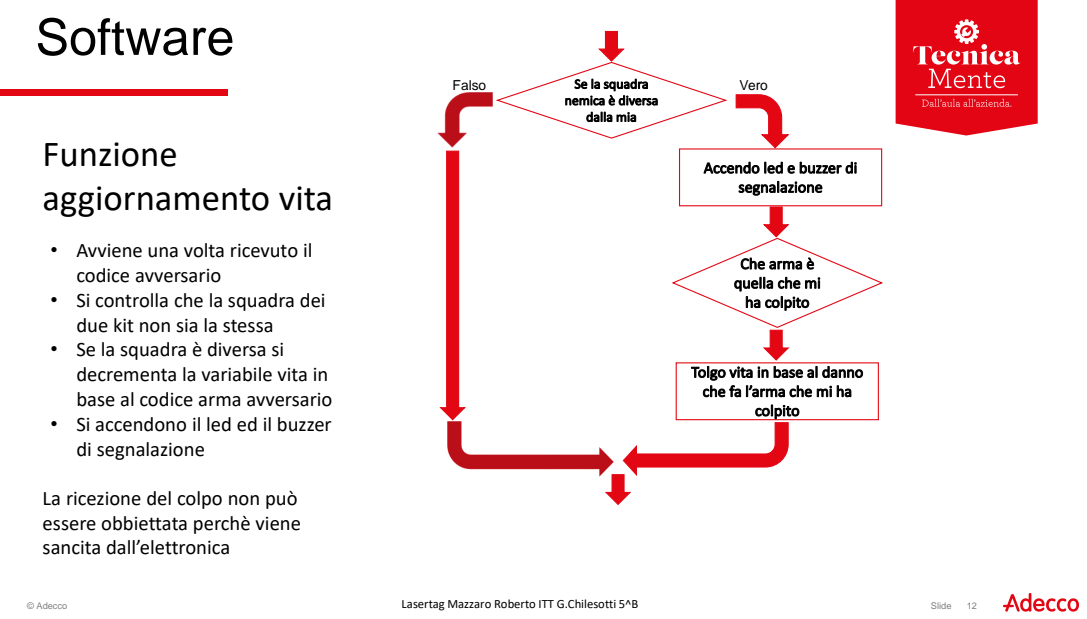
[picture p49: page 12]
aggiornamento vita; Falso; Vero

• Avviene una volta ricevuto il
codice avversario
• Si controlla che la squadra dei
due kit non sia la stessa
• Se la squadra è diversa si
decrementa la variabile vita in
base al codice arma avversario
• Si accendono il led ed il buzzer
di segnalazione

La ricezione del colpo non può
essere obbiettata perchè viene
sancita dall’elettronica

# Software

# Funzione di ricarica

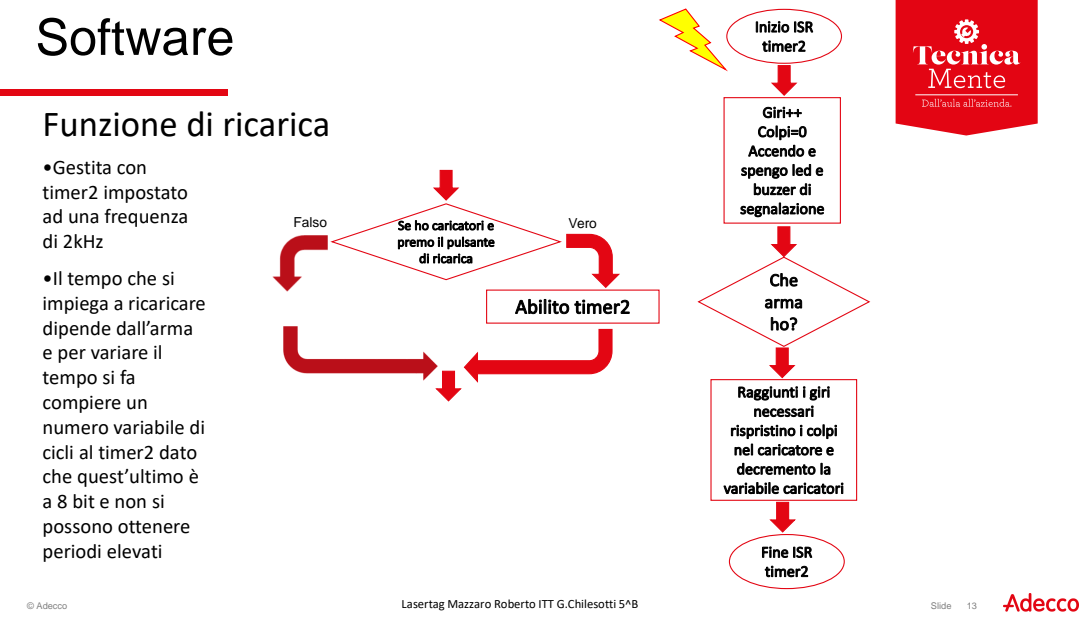
[picture p50: page 13]
Falso; Vero

•Gestita con
timer2 impostato
ad una frequenza
di 2kHz
•Il tempo che si
impiega a ricaricare
dipende dall’arma
e per variare il
tempo si fa
compiere un
numero variabile di
cicli al timer2 dato
che quest’ultimo è
a 8 bit e non si
possono ottenere
periodi elevati

# Struttura esterna

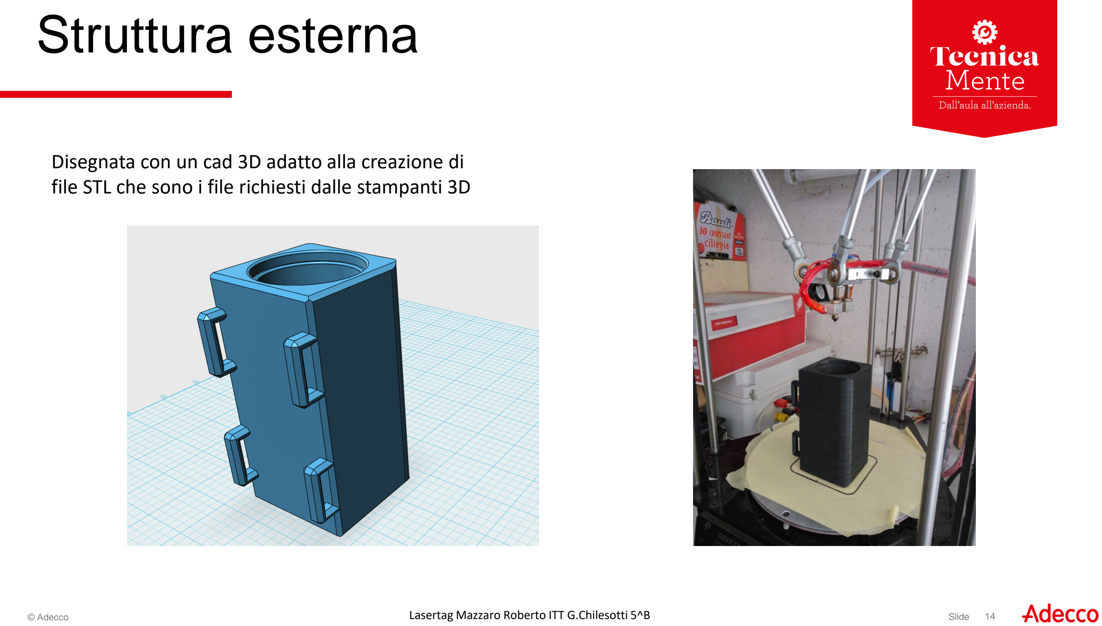
[picture p51: page 14]

Disegnata con un cad 3D adatto alla creazione di file STL che sono i file richiesti dalle stampanti 3D

# Ringraziamenti

Ringrazio inoltre tutti i professori che mi hanno seguito nella realizzazione di questo progetto in particolare i professori Franco Duso e Piergiuseppe Dal Santo

# Grazie per l’attenzione
