Rmazze/LaserGame/structure/impugnatura.stl

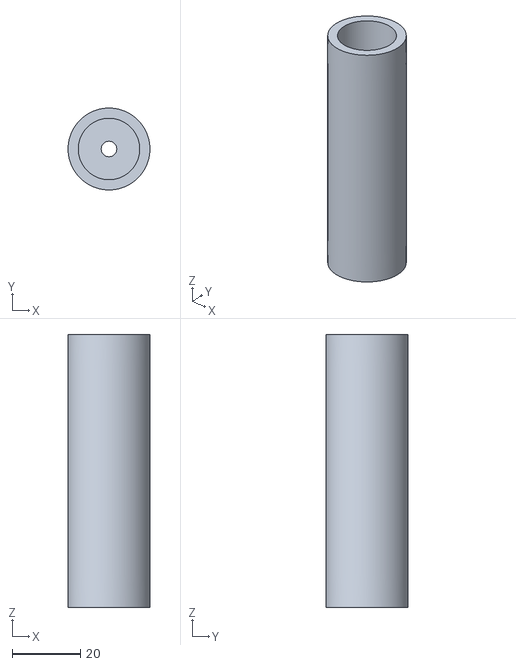
[picture p52: CAD file, 2023-07-28]
structure/impugnatura.stl
24.0 x 24.0 x 80.0
