Rmazze/LaserGame/structure/ottica.stl

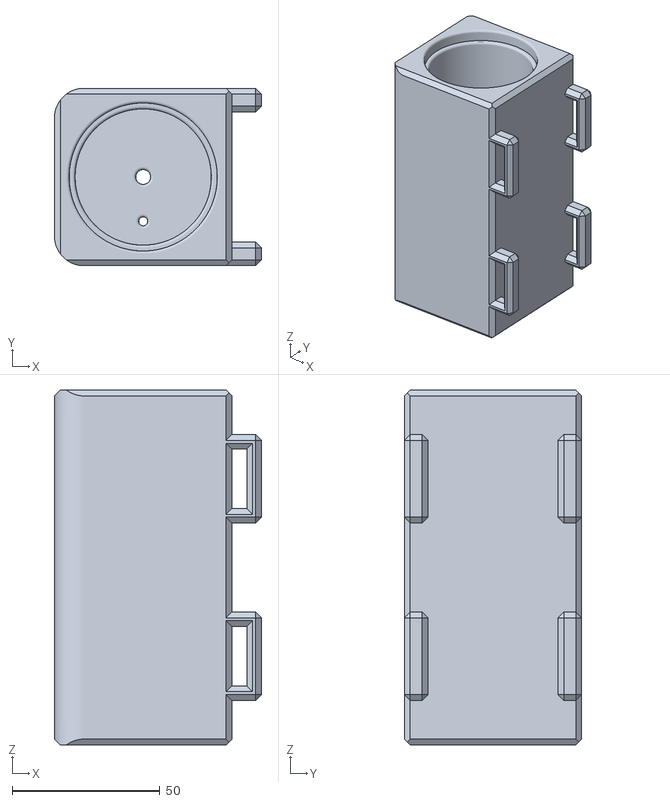
[picture p53: CAD file, 2023-07-28]
structure/ottica.stl
70.0 x 60.0 x 120.0
