Rmazze/LaserGame/arduino/lasertagcompletoscheda2/sparo.ino

int FUNZIONESPARO()
{
    //Serial.println("funzione sparo");
    digitalWrite(ledfiam, HIGH);
    digitalWrite(buzsp, HIGH);
    digitalWrite(IR555, HIGH);
    delayMicroseconds(BitStart);
    digitalWrite(IR555, LOW);
    delayMicroseconds(basso);
    switch (SQUADRA)
    {
      case 0: digitalWrite(IR555, HIGH);
                delayMicroseconds(bin_0);
                digitalWrite(IR555, LOW);
                delayMicroseconds(basso);
                digitalWrite(IR555, HIGH);
                delayMicroseconds(bin_0);
                digitalWrite(IR555, LOW);
                delayMicroseconds(basso);
                break;
                
      case 1: digitalWrite(IR555, HIGH);
                delayMicroseconds(bin_1);
                digitalWrite(IR555, LOW);
                delayMicroseconds(basso);
                digitalWrite(IR555, HIGH);
                delayMicroseconds(bin_0);
                digitalWrite(IR555, LOW);
                delayMicroseconds(basso);
                break;
                
      case 2: digitalWrite(IR555, HIGH);
                delayMicroseconds(bin_0);
                digitalWrite(IR555, LOW);
                delayMicroseconds(basso);
                digitalWrite(IR555, HIGH);
                delayMicroseconds(bin_1);
                digitalWrite(IR555, LOW);
                delayMicroseconds(basso);
                break;
                
      case 3: digitalWrite(IR555, HIGH);
                delayMicroseconds(bin_1);
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
                 digitalWrite(IR555, LOW);
                 delayMicroseconds(basso);
                 digitalWrite(IR555, HIGH);
                 delayMicroseconds(bin_1);
                 digitalWrite(IR555, LOW);
                 delayMicroseconds(basso);
                 break;

      case 7:  digitalWrite(IR555, HIGH);  // libero
                 delayMicroseconds(bin_1);
                 digitalWrite(IR555, LOW);
                 delayMicroseconds(basso);
                 digitalWrite(IR555, HIGH);
                 delayMicroseconds(bin_1);
                 digitalWrite(IR555, LOW);
                 delayMicroseconds(basso);
                 digitalWrite(IR555, HIGH);
                 delayMicroseconds(bin_1);
                 digitalWrite(IR555, LOW);
                 delayMicroseconds(basso);
                 break;
                 
    default:  digitalWrite(IR555, HIGH); //colpo di striscio
                  delayMicroseconds(bin_0);
                  digitalWrite(IR555, LOW);
                  delayMicroseconds(basso);
                  digitalWrite(IR555, HIGH);
                  delayMicroseconds(bin_0);
                  digitalWrite(IR555, LOW);
                  delayMicroseconds(basso);
                  digitalWrite(IR555, HIGH);
                  delayMicroseconds(bin_0);
                  digitalWrite(IR555, LOW);
                  delayMicroseconds(basso);
                  break;
    }
    colpi--;
    digitalWrite(ledfiam, LOW);
    digitalWrite(buzsp, LOW);
    sparo=0;
}
